ptymek/forma_wtryskowa_przts_WIP/DOC/WYPRASKA_NIEPRZEZROCZYSTA.BMP

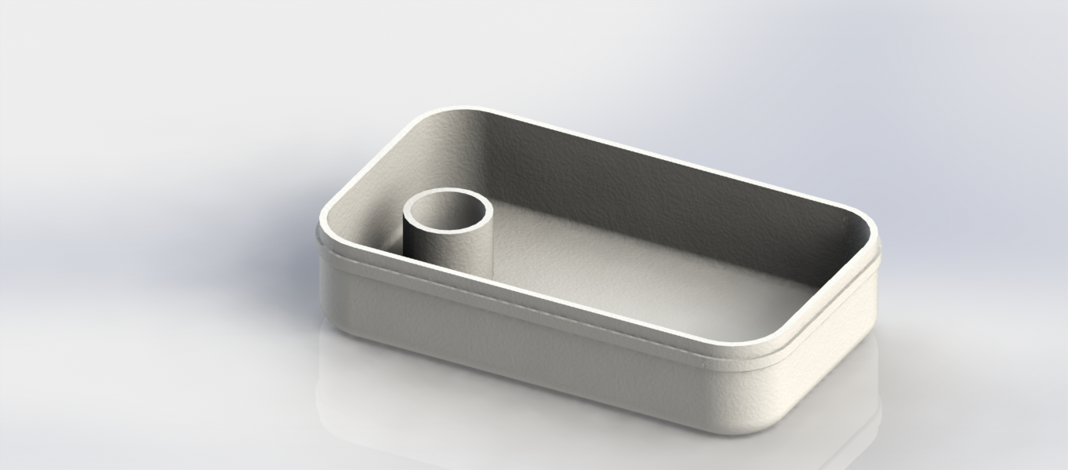
DOC/WYPRASKA_NIEPRZEZROCZYSTA.BMP
