ptymek/forma_wtryskowa_przts_WIP/DOC/WTRYSK.BMP

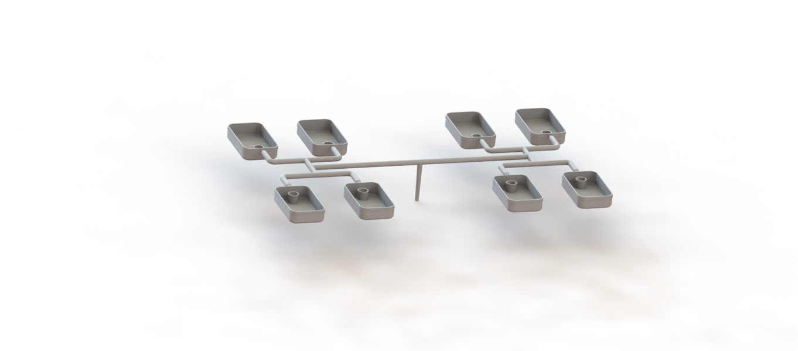
DOC/WTRYSK.BMP
