ptymek/forma_wtryskowa_przts_WIP/DOC/WYPRASKA_PRZEZROCZYSTA.BMP

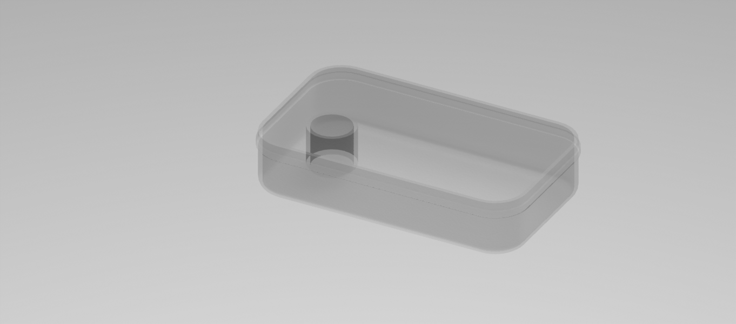
DOC/WYPRASKA_PRZEZROCZYSTA.BMP
