ptymek/forma_wtryskowa_przts_WIP/Przechwytywanie w trybie pełnoekranowym 2015-01-06 133430.bmp.jpg

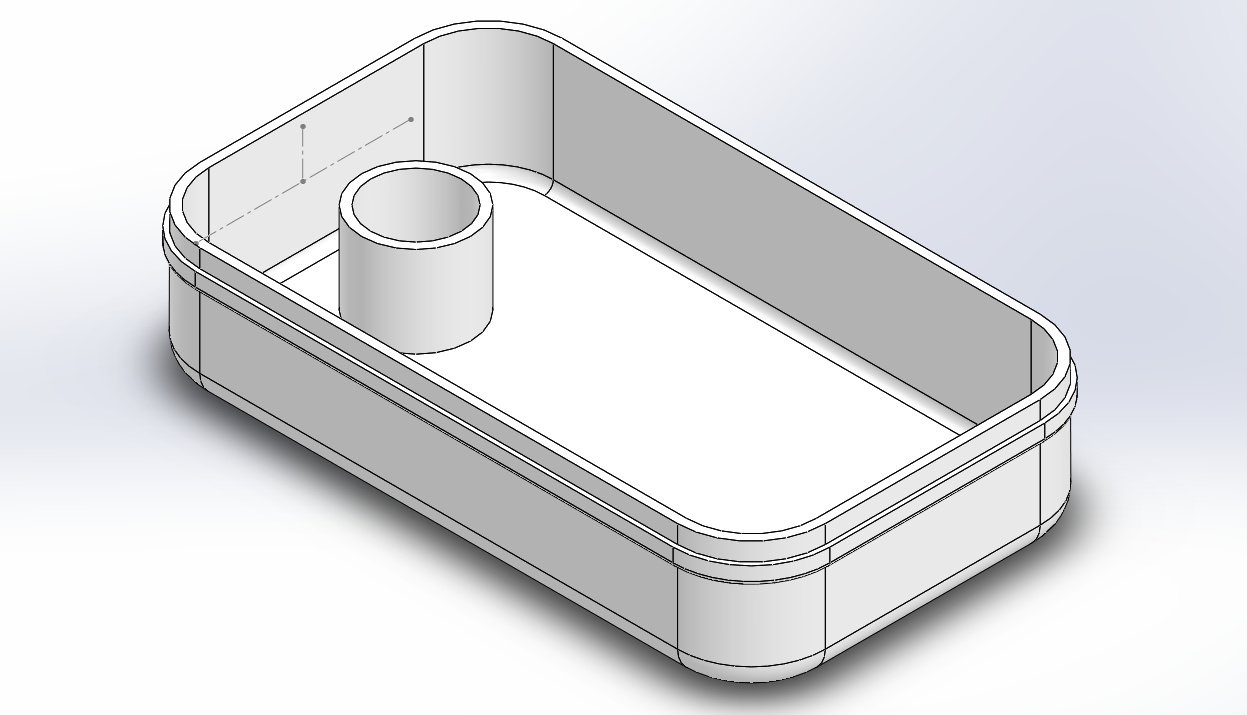
Przechwytywanie w trybie pełnoekranowym 2015-01-06 133430.bmp.jpg
