ptymek/forma_wtryskowa_przts_WIP/WYPRASKA/TYMIŃSKI_PRZTS_WTRYSK.SLDASM

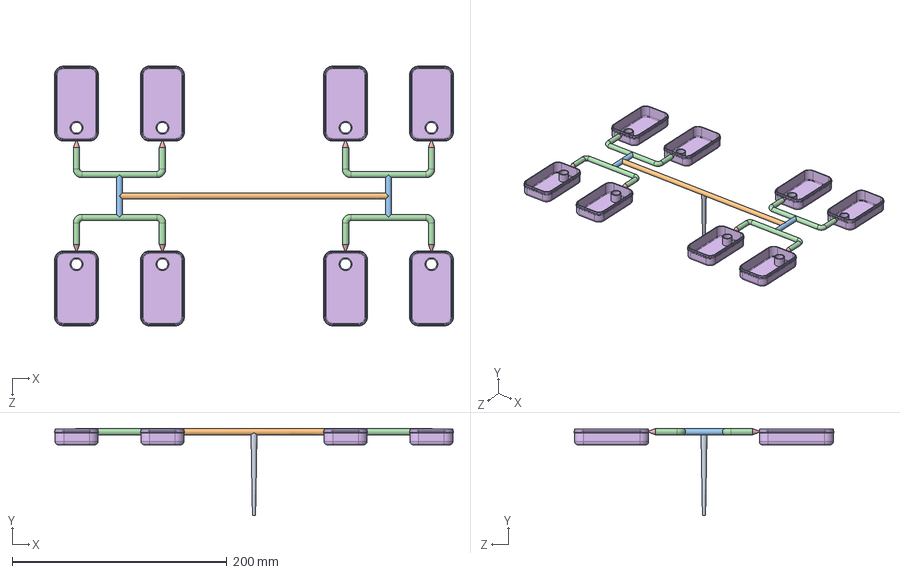
[picture p26: CAD file, 2019-07-03]
WYPRASKA/TYMIŃSKI_PRZTS_WTRYSK.SLDASM
371.5 x 81.0 x 242.0 mm
TYMIŃSKI_PRZTS_MODEL_KANAŁ_WTRYSKU
TYMIŃSKI_PRZTS_MODEL_KANAŁ_GŁOWNY
TYMIŃSKI_PRZTS_MODEL_KANAŁ_DOLOTOWY x 2
TYMIŃSKI_PRZTS_MODEL_ŁĄCZNIK x 4
TYMIŃSKI_PRZTS_MODEL_PRZEWĘŻKA x 8
TYMIŃSKI_PRZTS_WYPRASKA x 8
