ptymek/forma_wtryskowa_przts_WIP/ZŁOŻENIA/TYMIŃSKI_PRZTS_GÓRA.SLDASM

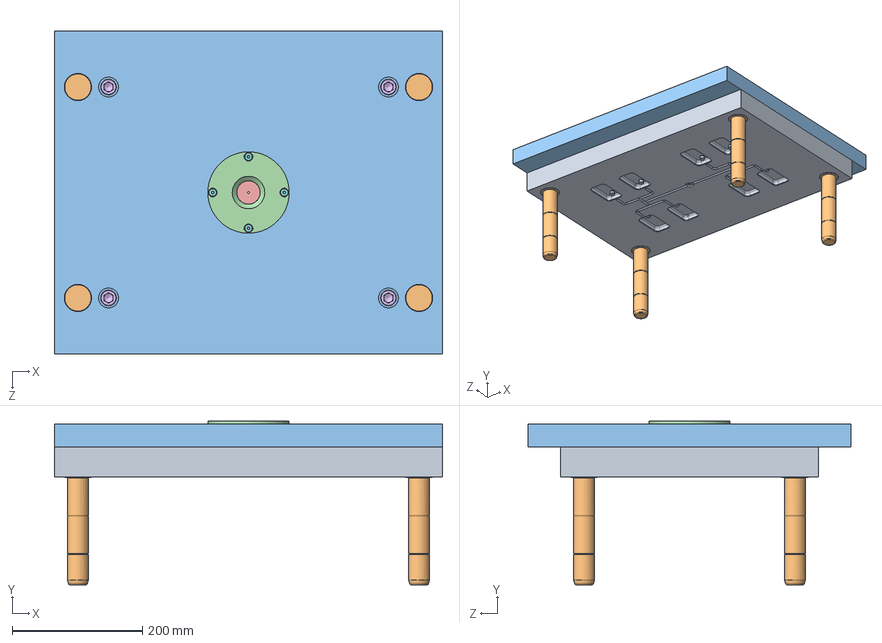
[picture p27: CAD file, 2019-07-03]
ZŁOŻENIA/TYMIŃSKI_PRZTS_GÓRA.SLDASM
596.0 x 251.3 x 496.0 mm
PK31_FORMA
SLE_32046165_1_7131 x 4
PK11_GÓRNA
PCA_125080_wg_FCPK
TWC_183056_1_8159
socket head cap screw_iso x 4
parallel pin hardened_iso
socket countersunk head screw_iso x 4
