ptymek/forma_wtryskowa_przts_WIP/ZŁOŻENIA/TYMIŃSKI_PRZTS_SPRĘŻYNA_WYPYCHACZY.SLDASM

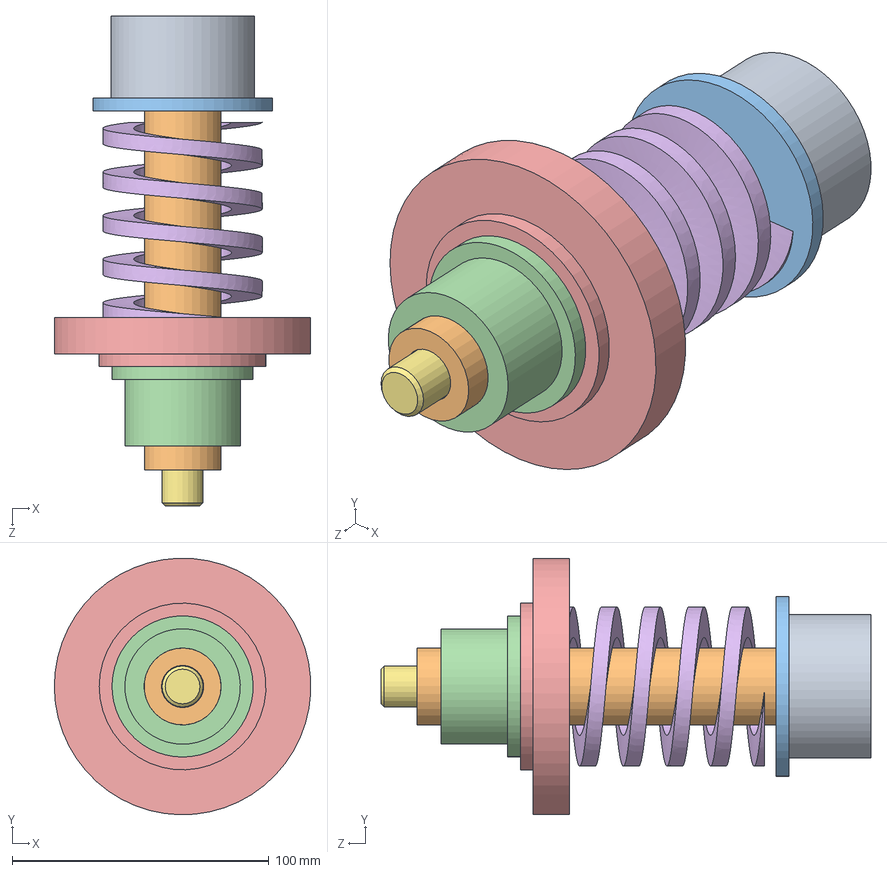
[picture p28: CAD file, 2019-07-03]
ZŁOŻENIA/TYMIŃSKI_PRZTS_SPRĘŻYNA_WYPYCHACZY.SLDASM
99.9 x 100.0 x 191.0 mm
POA_5632_wg_FCPK
TPZ_30140_wg_FCPK
WYPYCHACZ_PODKŁADKA
WYPYCHACZ_TULEJA_1
WYPYCHACZ_TULEJA_2
SPRĘŻYNA
SM_16170_wg_FCPK
