ptymek/forma_wtryskowa_przts_WIP/ZŁOŻENIA/TYMIŃSKI_PRZTS_PŁYTA_WYPYCHACZY.SLDASM

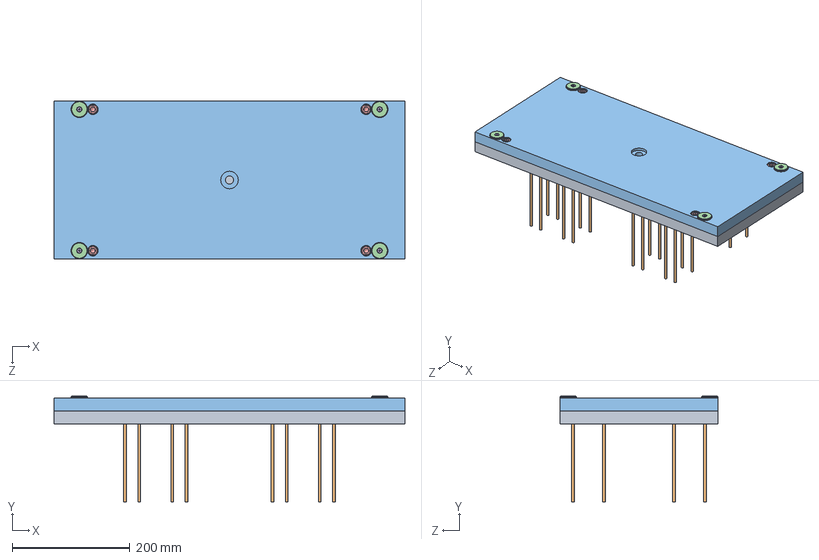
[picture p29: CAD file, 2019-07-03]
ZŁOŻENIA/TYMIŃSKI_PRZTS_PŁYTA_WYPYCHACZY.SLDASM
596.0 x 179.2 x 268.0 mm
PK06
EM_050160_1_2344 x 32
PK07
PO_2803_wg_FCPK x 4
socket head cap screw_iso x 4
socket countersunk head screw_iso x 4
