ptymek/forma_wtryskowa_przts_WIP/WYPRASKA/Złożenie2.SLDASM

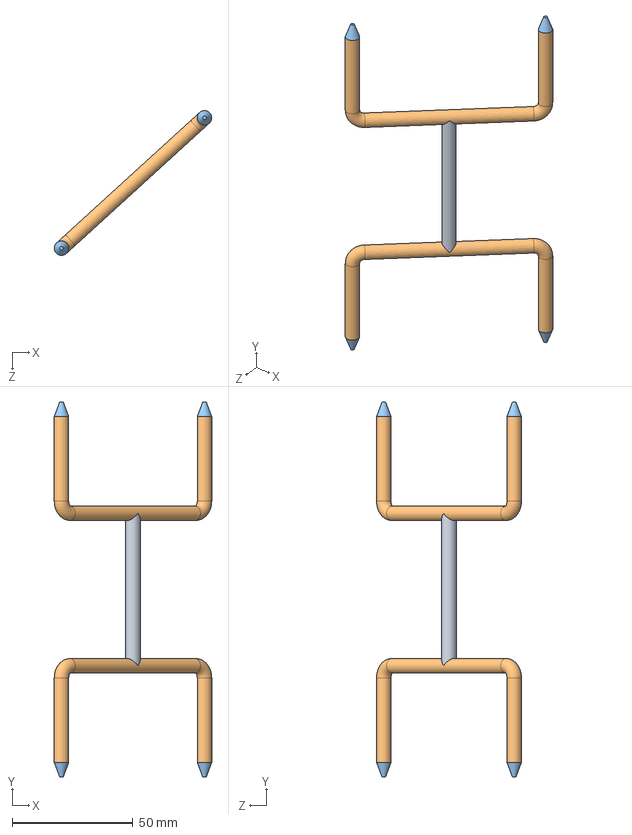
[picture p30: CAD file, 2019-07-03]
WYPRASKA/Złożenie2.SLDASM
65.1 x 155.0 x 59.9 mm
TYMIŃSKI_PRZTS_MODEL_KANAŁ_DOLOTOWY
TYMIŃSKI_PRZTS_MODEL_ŁĄCZNIK x 2
TYMIŃSKI_PRZTS_MODEL_PRZEWĘŻKA x 4
