ptymek/forma_wtryskowa_przts_WIP/ZŁOŻENIA/TYMIŃSKI_PRZTS_DÓŁ.SLDASM

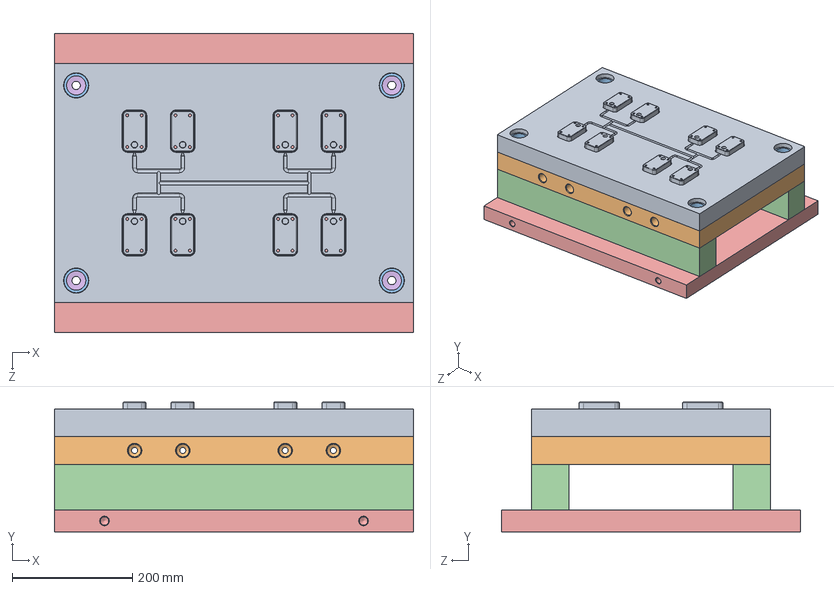
[picture p31: CAD file, 2019-07-03]
ZŁOŻENIA/TYMIŃSKI_PRZTS_DÓŁ.SLDASM
596.0 x 215.2 x 496.0 mm
PK31_MATRYCA
PK04
TPE_32036_1_7131 x 4
PK05
PK11_DOLNA
TUE_42140_1_7131 x 4
socket head cap screw_iso x 4
