ptymek/forma_wtryskowa_przts_WIP/FORMA_WTRYSKOWA/TYMIŃSKI_FORMA_WTRYSKOWA.SLDASM

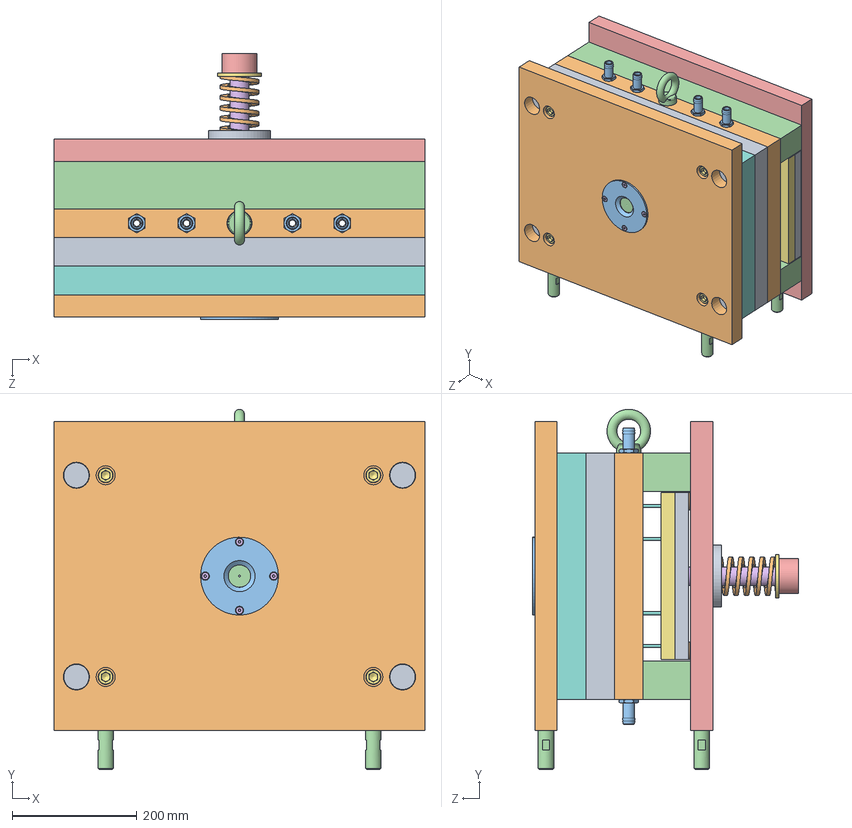
[picture p32: CAD file, 2019-07-03]
FORMA_WTRYSKOWA/TYMIŃSKI_FORMA_WTRYSKOWA.SLDASM
596.0 x 579.0 x 428.0 mm
PK31_MATRYCA
PK04
TPE_32036_1_7131 x 4
PK05
PK11_DOLNA
TUE_42140_1_7131 x 4
socket head cap screw_iso x 16
PK31_FORMA
SLE_32046165_1_7131 x 4
PK11_GÓRNA
PCA_125080_wg_FCPK
TWC_183056_1_8159
parallel pin hardened_iso
socket countersunk head screw_iso x 8
PK06
EM_050160_1_2344 x 32
PK07
PO_2803_wg_FCPK x 4
UHE_M24_MS58_Brass_ x 8
SUM_20_wg_FCPK
POA_5632_wg_FCPK
TPZ_30140_wg_FCPK
WYPYCHACZ_PODKŁADKA
WYPYCHACZ_TULEJA_1
WYPYCHACZ_TULEJA_2
SPRĘŻYNA
SM_16170_wg_FCPK
NF_16088_wg_FCPK x 4
