ptymek/forma_wtryskowa_przts_WIP/WYPRASKA/Złożenie2^TYMIŃSKI_PRZTS_WTRYSK.sldasm

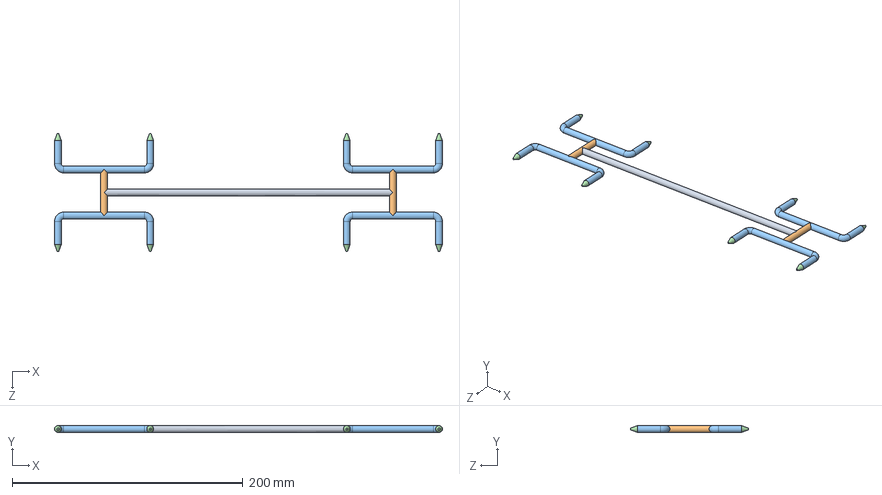
[picture p33: CAD file, 2019-07-03]
WYPRASKA/Złożenie2^TYMIŃSKI_PRZTS_WTRYSK.sldasm
336.5 x 6.00 x 102.0 mm
TYMIŃSKI_PRZTS_MODEL_KANAŁ_GŁOWNY
TYMIŃSKI_PRZTS_MODEL_KANAŁ_DOLOTOWY x 2
TYMIŃSKI_PRZTS_MODEL_ŁĄCZNIK x 4
TYMIŃSKI_PRZTS_MODEL_PRZEWĘŻKA x 8
