ptymek/forma_wtryskowa_przts_WIP/FORMA_WTRYSKOWA/ZESPÓŁ_WYPYCHACZY.SLDASM

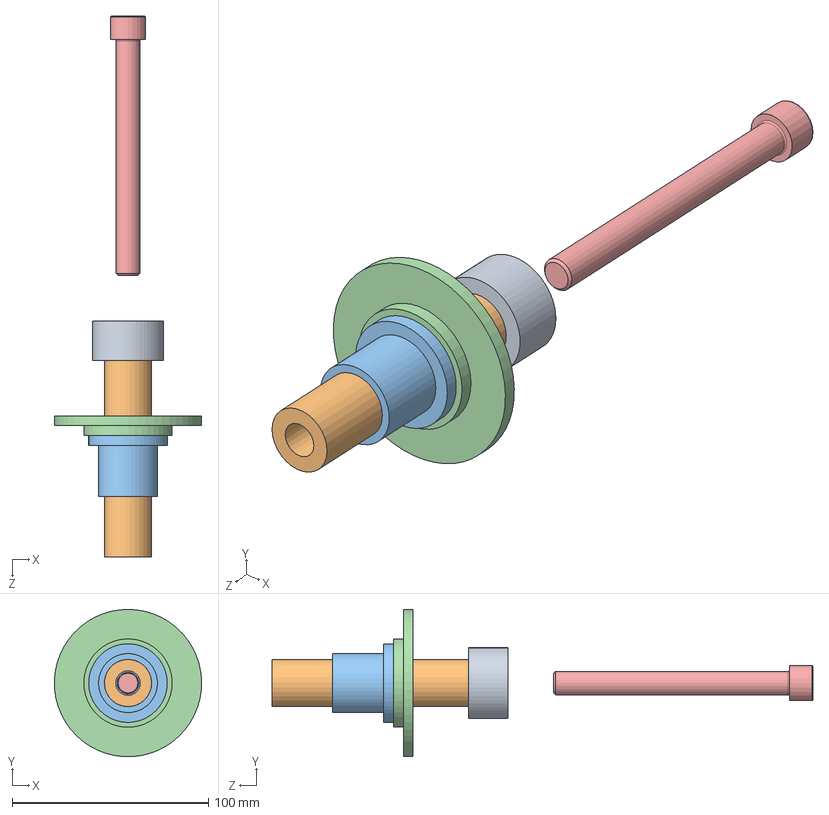
[picture p34: CAD file, 2019-07-03]
FORMA_WTRYSKOWA/ZESPÓŁ_WYPYCHACZY.SLDASM
75.0 x 74.9 x 275.4 mm
POA_3620_wg_FCPK
TPZ_24100_wg_FCPK
WYPYCHACZ_TULEJA_1
WYPYCHACZ_TULEJA_2
socket head cap screw_iso
