ptymek/forma_wtryskowa_przts_WIP/FORMA_WTRYSKOWA/CZĘŚĆI_ZNORMALIZOWANE/EM_050125_1_2344.sldprt

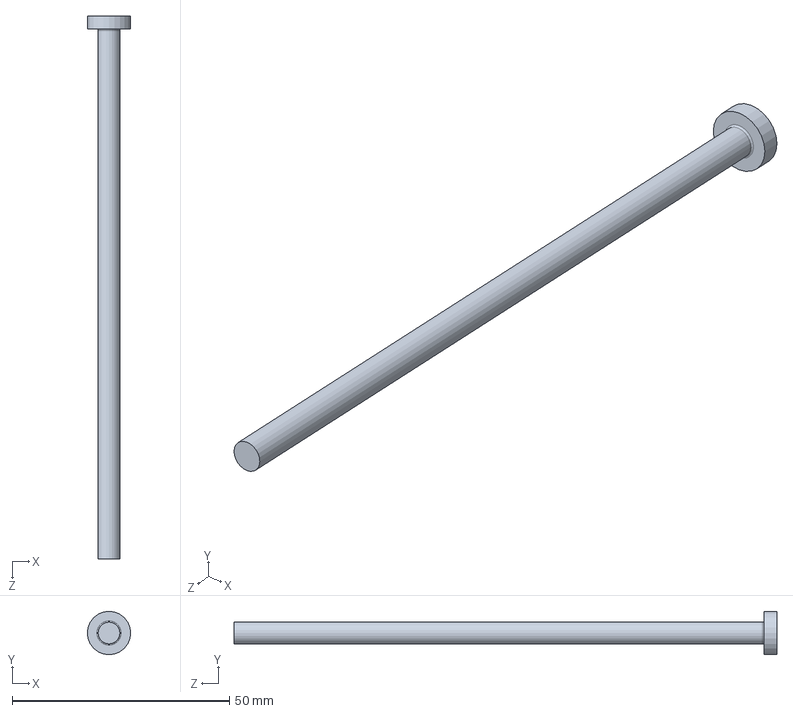
[picture p35: CAD file, 2019-07-03]
FORMA_WTRYSKOWA/CZĘŚĆI_ZNORMALIZOWANE/EM_050125_1_2344.sldprt
10.0 x 10.0 x 125.0 mm
