ptymek/forma_wtryskowa_przts_WIP/FORMA_WTRYSKOWA/CZĘŚĆI_ZNORMALIZOWANE/FCPKBYTOW/SM_16150_wg_FCPK.sldprt

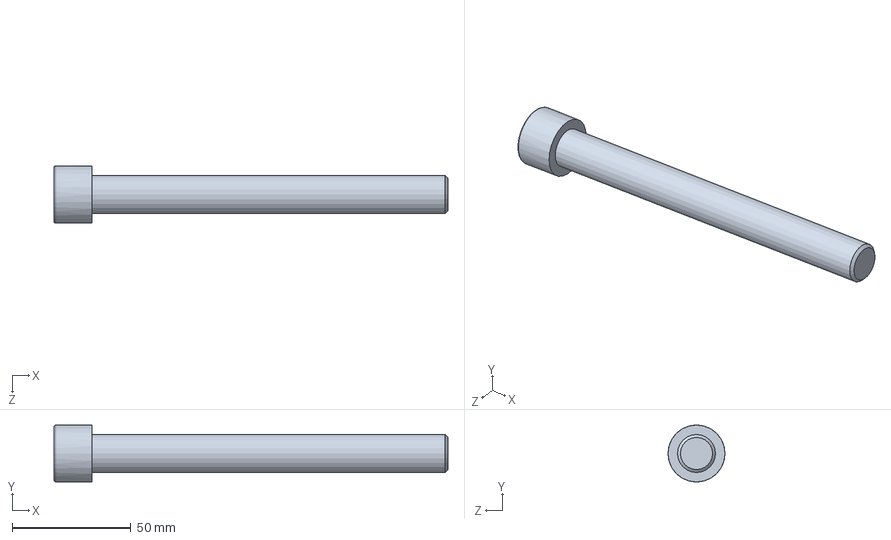
[picture p36: CAD file, 2019-07-03]
FORMA_WTRYSKOWA/CZĘŚĆI_ZNORMALIZOWANE/FCPKBYTOW/SM_16150_wg_FCPK.sldprt
166.0 x 24.0 x 24.0 mm
