ptymek/forma_wtryskowa_przts_WIP/FORMA_WTRYSKOWA/PODKŁADKA_OPOROWA.SLDPRT

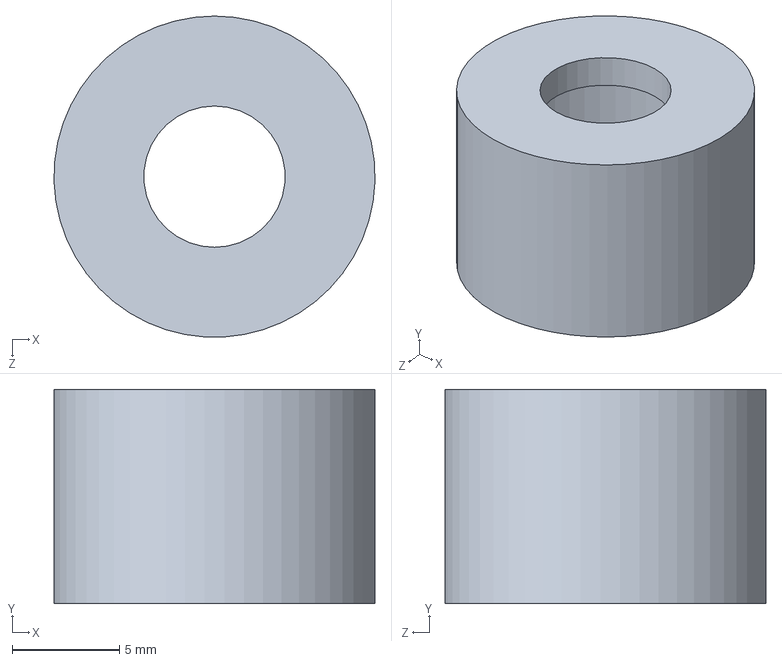
[picture p37: CAD file, 2019-07-03]
FORMA_WTRYSKOWA/PODKŁADKA_OPOROWA.SLDPRT
15.0 x 10.0 x 15.0 mm
