ptymek/forma_wtryskowa_przts_WIP/FORMA_WTRYSKOWA/CZĘŚĆI_ZNORMALIZOWANE/FCPKBYTOW/WK_0408_wg_DIN.sldprt

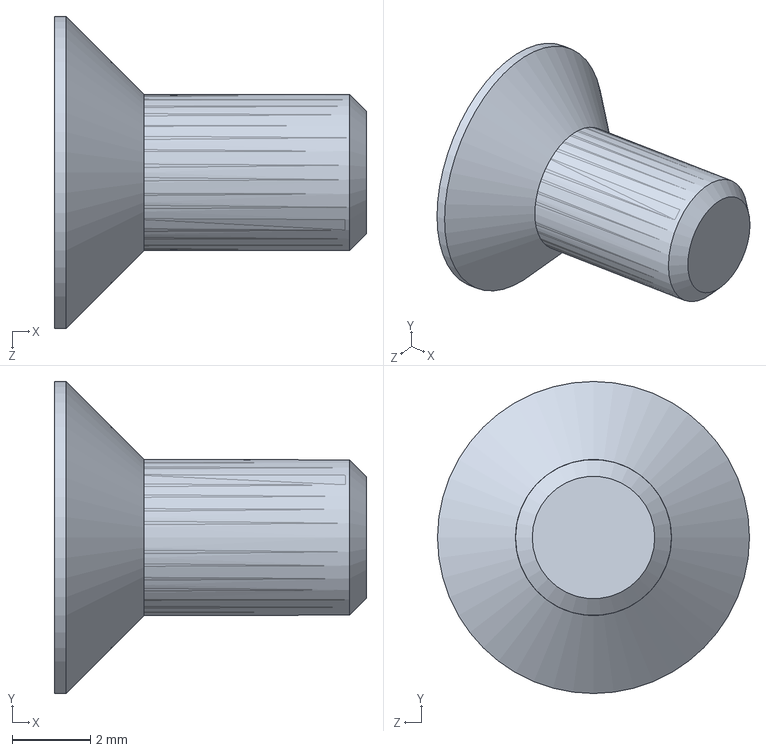
[picture p38: CAD file, 2019-07-03]
FORMA_WTRYSKOWA/CZĘŚĆI_ZNORMALIZOWANE/FCPKBYTOW/WK_0408_wg_DIN.sldprt
8.00 x 8.00 x 8.00 mm
