ptymek/forma_wtryskowa_przts_WIP/FORMA_WTRYSKOWA/CZĘŚĆI_ZNORMALIZOWANE/parallel pin hardened_iso.sldprt

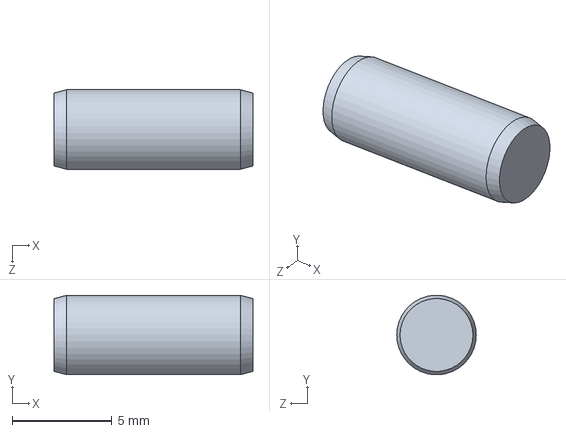
[picture p39: CAD file, 2019-07-03]
FORMA_WTRYSKOWA/CZĘŚĆI_ZNORMALIZOWANE/parallel pin hardened_iso.sldprt
10.0 x 3.99 x 4.00 mm
