ptymek/forma_wtryskowa_przts_WIP/FORMA_WTRYSKOWA/WYPYCHACZ_TULEJA_1.SLDPRT

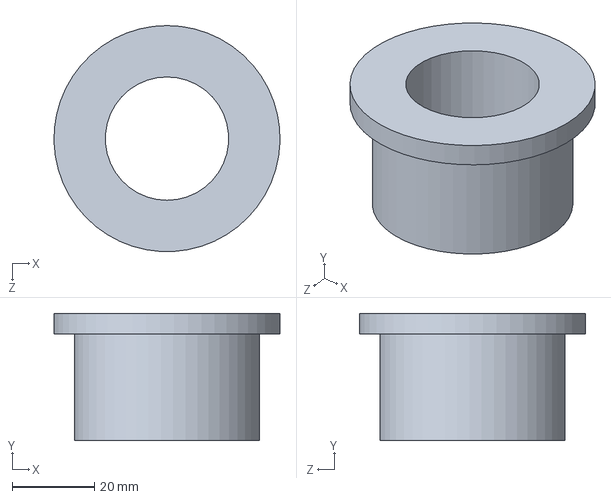
[picture p40: CAD file, 2019-07-03]
FORMA_WTRYSKOWA/WYPYCHACZ_TULEJA_1.SLDPRT
55.0 x 31.0 x 54.9 mm
