ptymek/forma_wtryskowa_przts_WIP/WYPRASKA/TYMIŃSKI_PRZTS_MODEL.SLDPRT

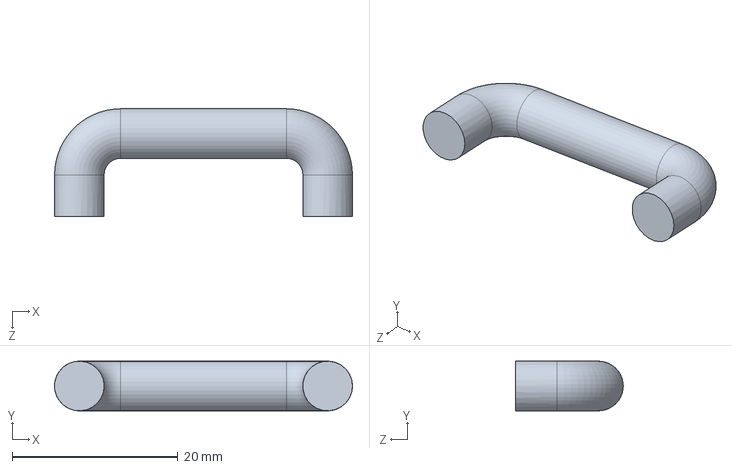
[picture p41: CAD file, 2019-07-03]
WYPRASKA/TYMIŃSKI_PRZTS_MODEL.SLDPRT
36.0 x 5.99 x 13.0 mm
