ptymek/forma_wtryskowa_przts_WIP/FORMA_WTRYSKOWA/CZĘŚĆI_ZNORMALIZOWANE/FCPKBYTOW/PK_11_496x596x36_35_1730_1_1730.sldprt

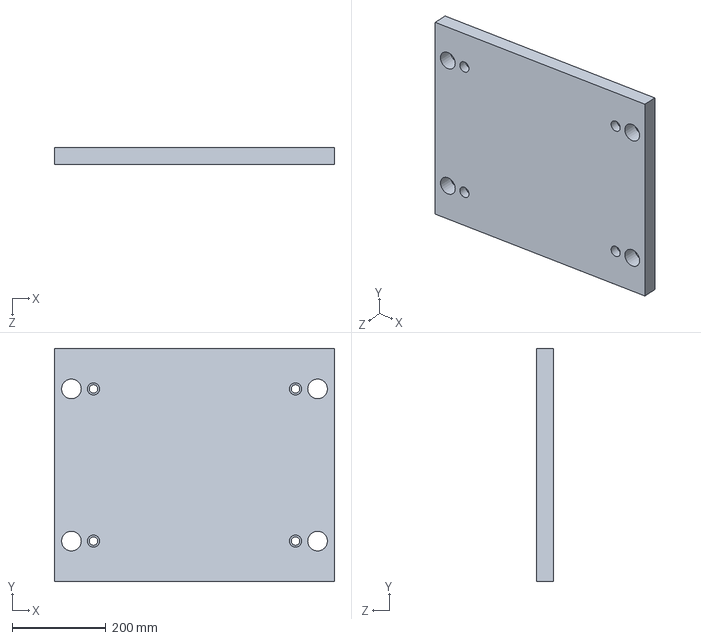
[picture p42: CAD file, 2019-07-03]
FORMA_WTRYSKOWA/CZĘŚĆI_ZNORMALIZOWANE/FCPKBYTOW/PK_11_496x596x36_35_1730_1_1730.sldprt
596.0 x 496.0 x 36.0 mm
