ptymek/forma_wtryskowa_przts_WIP/FORMA_WTRYSKOWA/CZĘŚĆI_ZNORMALIZOWANE/NF_16088_wg_FCPK.sldprt

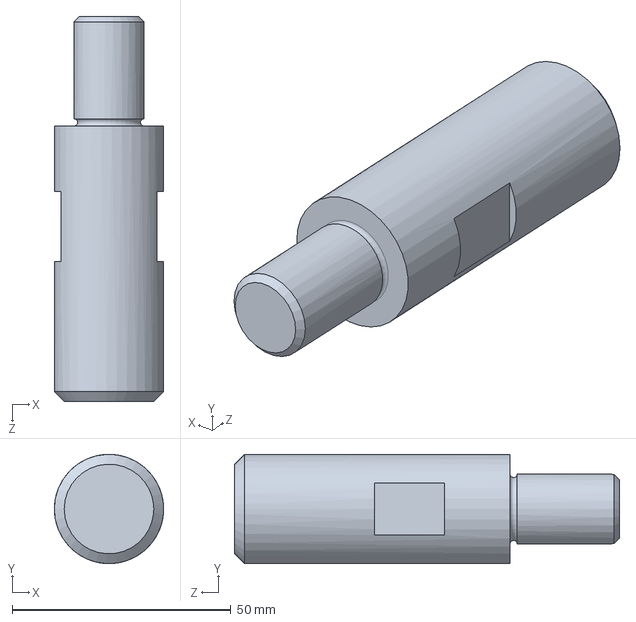
[picture p43: CAD file, 2019-07-03]
FORMA_WTRYSKOWA/CZĘŚĆI_ZNORMALIZOWANE/NF_16088_wg_FCPK.sldprt
25.0 x 25.0 x 88.0 mm
