ptymek/forma_wtryskowa_przts_WIP/FORMA_WTRYSKOWA/PK05.SLDPRT

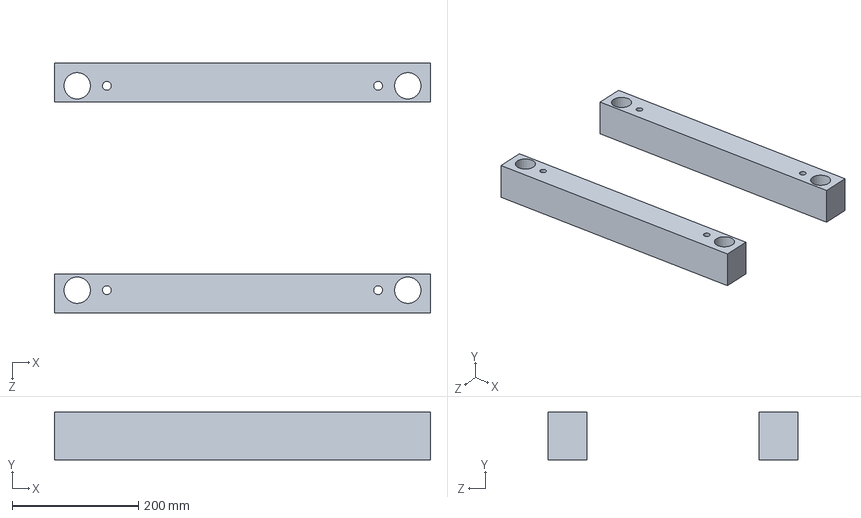
[picture p44: CAD file, 2019-07-03]
FORMA_WTRYSKOWA/PK05.SLDPRT
596.0 x 76.0 x 396.0 mm
