ptymek/forma_wtryskowa_przts_WIP/WYPRASKA/TYMIŃSKI_PRZTS_MODEL_PRZEWĘŻKA.SLDPRT

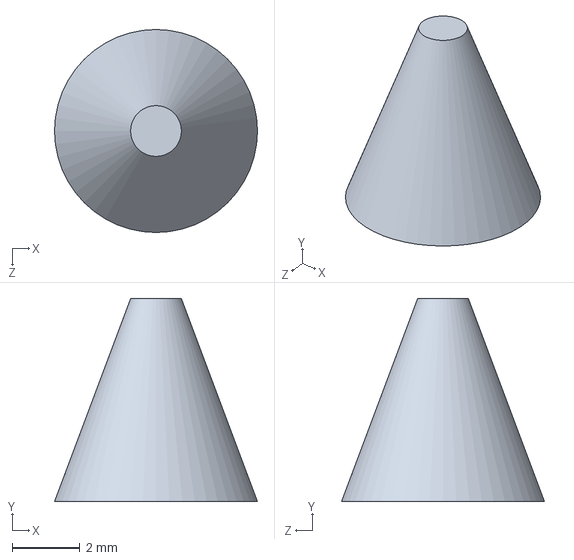
[picture p45: CAD file, 2019-07-03]
WYPRASKA/TYMIŃSKI_PRZTS_MODEL_PRZEWĘŻKA.SLDPRT
6.00 x 6.00 x 6.00 mm
