ptymek/forma_wtryskowa_przts_WIP/FORMA_WTRYSKOWA/CZĘŚĆI_ZNORMALIZOWANE/FCPKBYTOW/PK07_268x596x27_35_1730_1_1730.sldprt

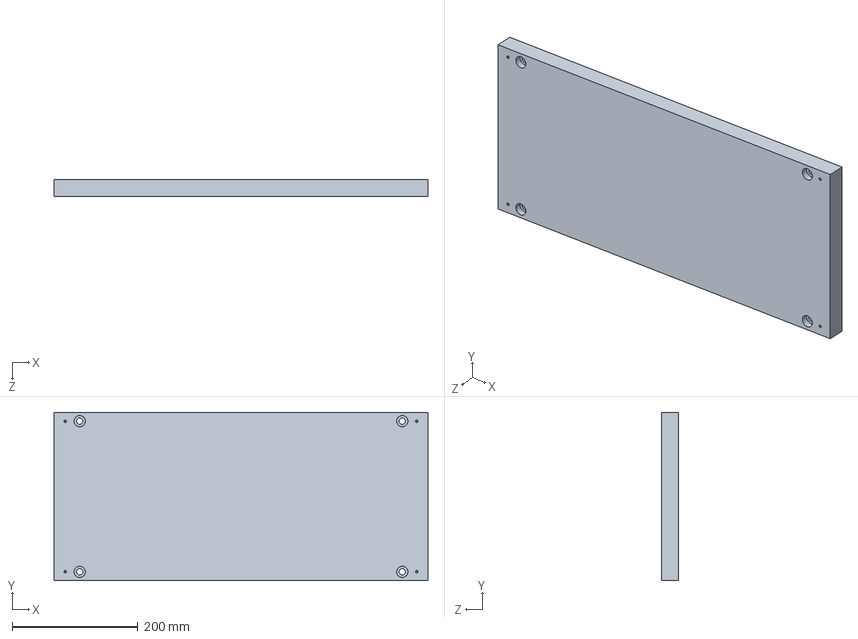
[picture p46: CAD file, 2019-07-03]
FORMA_WTRYSKOWA/CZĘŚĆI_ZNORMALIZOWANE/FCPKBYTOW/PK07_268x596x27_35_1730_1_1730.sldprt
596.0 x 268.0 x 27.0 mm
