ptymek/forma_wtryskowa_przts_WIP/FORMA_WTRYSKOWA/WYPYCHACZ_TULEJA_2.SLDPRT

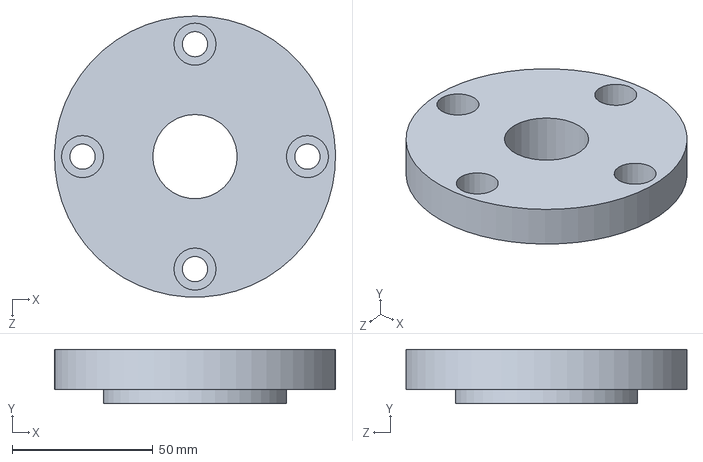
[picture p47: CAD file, 2019-07-03]
FORMA_WTRYSKOWA/WYPYCHACZ_TULEJA_2.SLDPRT
100.0 x 19.2 x 99.9 mm
