ptymek/forma_wtryskowa_przts_WIP/FORMA_WTRYSKOWA/CZĘŚĆI_ZNORMALIZOWANE/FCPKBYTOW/PK_05_62x596x76_35_1730_1_1730.sldprt

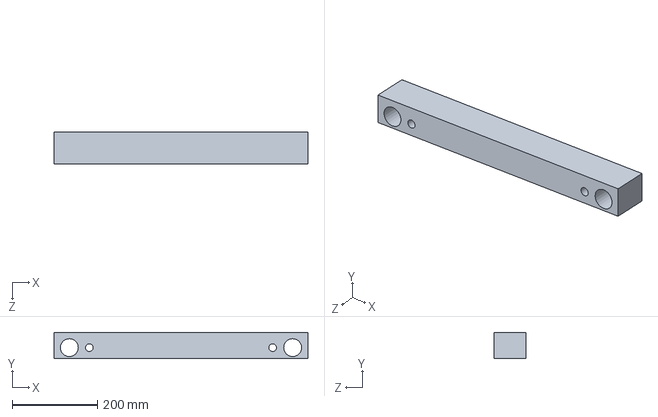
[picture p48: CAD file, 2019-07-03]
FORMA_WTRYSKOWA/CZĘŚĆI_ZNORMALIZOWANE/FCPKBYTOW/PK_05_62x596x76_35_1730_1_1730.sldprt
596.0 x 62.0 x 76.0 mm
