ptymek/forma_wtryskowa_przts_WIP/FORMA_WTRYSKOWA/CZĘŚĆI_ZNORMALIZOWANE/TPE_32036_1_7131.sldprt

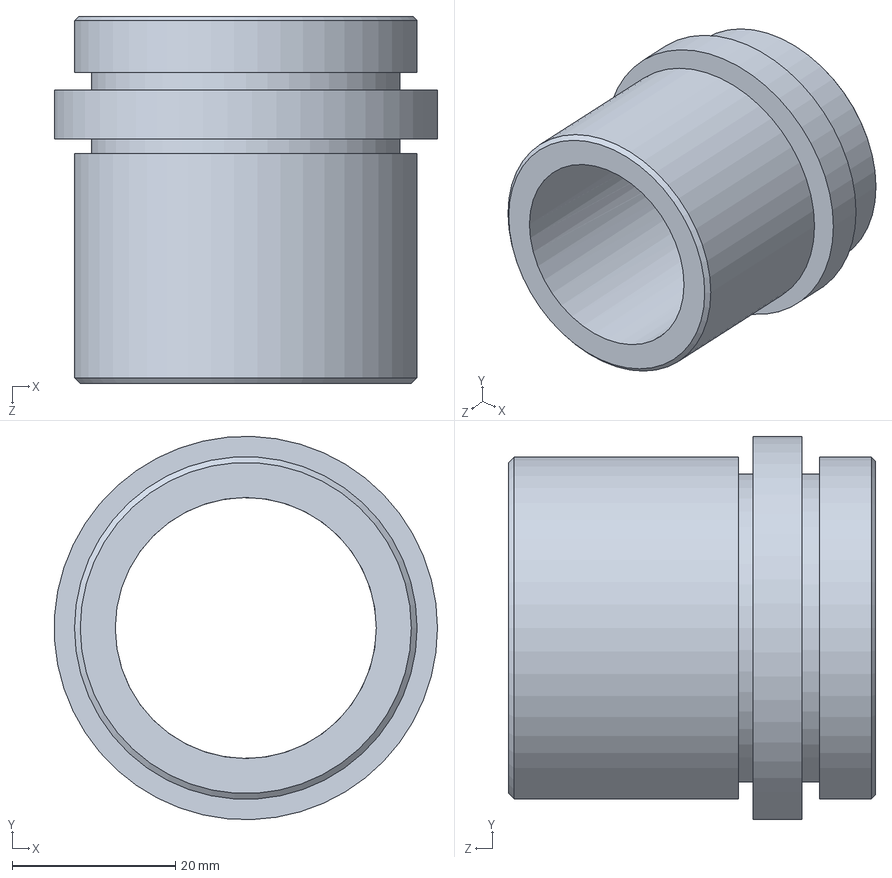
[picture p49: CAD file, 2019-07-03]
FORMA_WTRYSKOWA/CZĘŚĆI_ZNORMALIZOWANE/TPE_32036_1_7131.sldprt
47.0 x 47.0 x 45.0 mm
