ptymek/forma_wtryskowa_przts_WIP/FORMA_WTRYSKOWA/TULEJA_PROWADZĄCA.SLDPRT

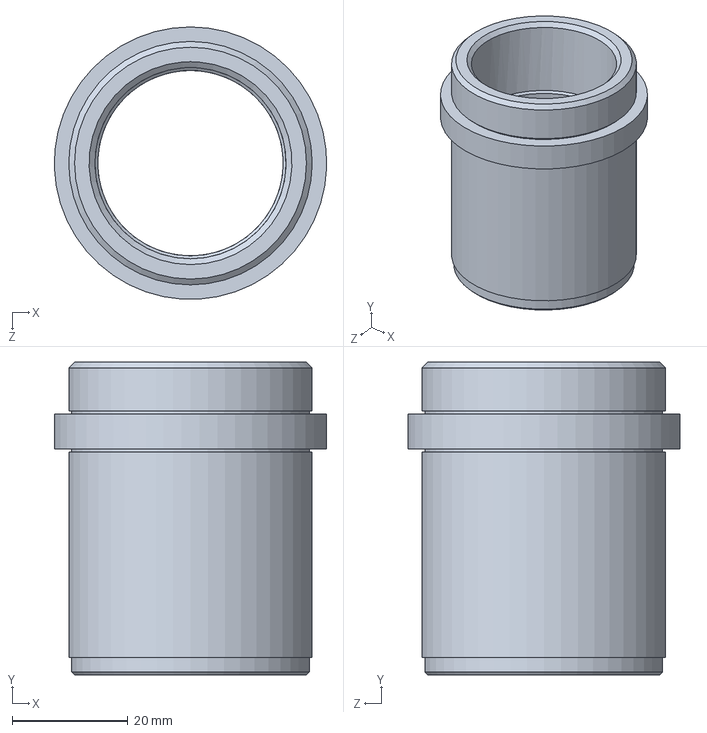
[picture p50: CAD file, 2019-07-03]
FORMA_WTRYSKOWA/TULEJA_PROWADZĄCA.SLDPRT
47.0 x 54.0 x 46.9 mm
