ptymek/forma_wtryskowa_przts_WIP/WYPRASKA/TYMIŃSKI_PRZTS_MODEL_ŁĄCZNIK.SLDPRT

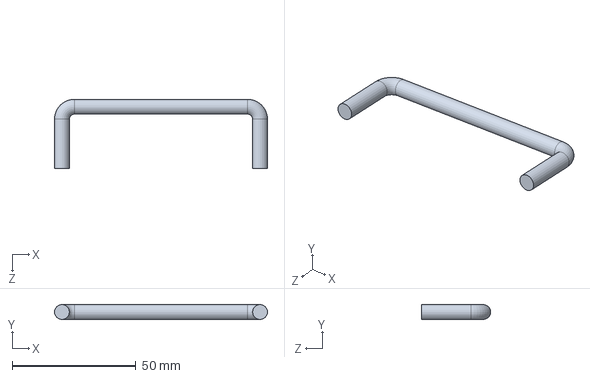
[picture p51: CAD file, 2019-07-03]
WYPRASKA/TYMIŃSKI_PRZTS_MODEL_ŁĄCZNIK.SLDPRT
86.0 x 6.00 x 28.0 mm
