ptymek/forma_wtryskowa_przts_WIP/FORMA_WTRYSKOWA/CZĘŚĆI_ZNORMALIZOWANE/FCPKBYTOW/PO_1803_wg_FCPK.sldprt

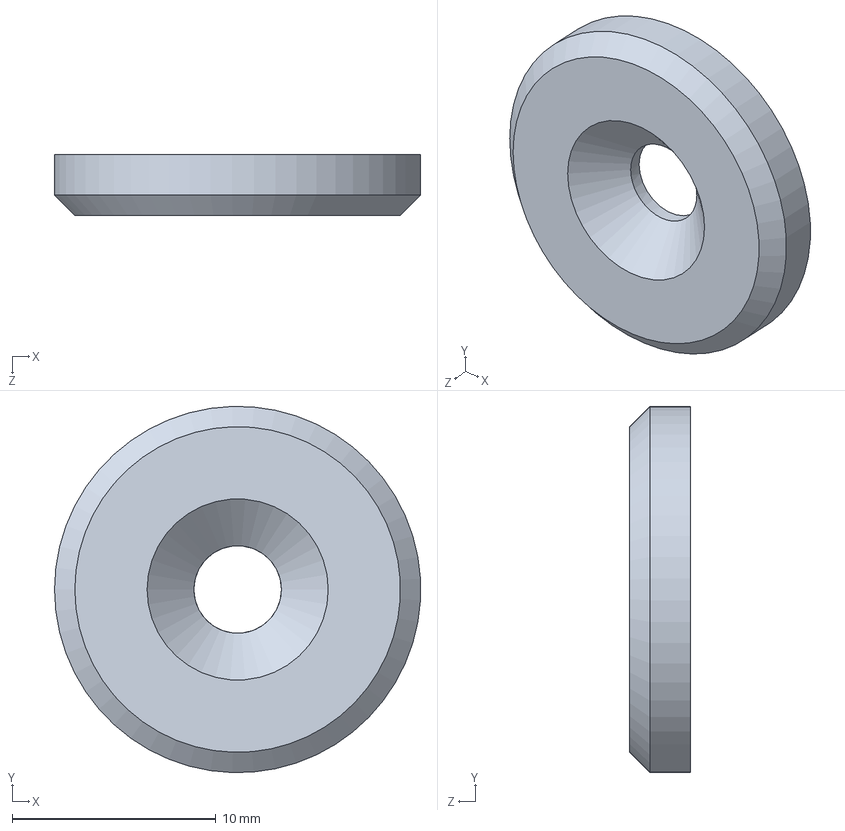
[picture p52: CAD file, 2019-07-03]
FORMA_WTRYSKOWA/CZĘŚĆI_ZNORMALIZOWANE/FCPKBYTOW/PO_1803_wg_FCPK.sldprt
18.0 x 18.0 x 3.00 mm
