ptymek/forma_wtryskowa_przts_WIP/FORMA_WTRYSKOWA/CZĘŚĆI_ZNORMALIZOWANE/SUM_20_wg_FCPK.sldprt

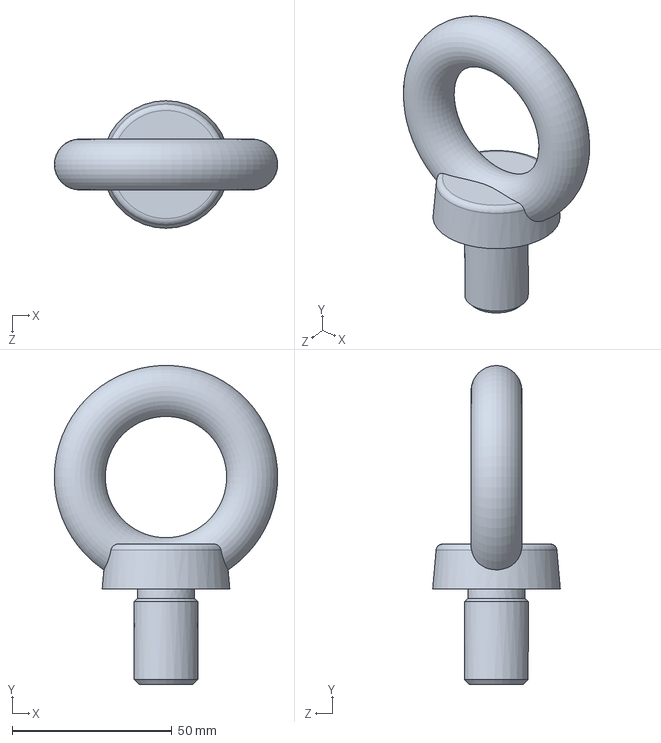
[picture p53: CAD file, 2019-07-03]
FORMA_WTRYSKOWA/CZĘŚĆI_ZNORMALIZOWANE/SUM_20_wg_FCPK.sldprt
70.0 x 100.0 x 40.0 mm
