ptymek/forma_wtryskowa_przts_WIP/WYPRASKA/TYMIŃSKI_PRZTS_WYPRASKA.SLDPRT

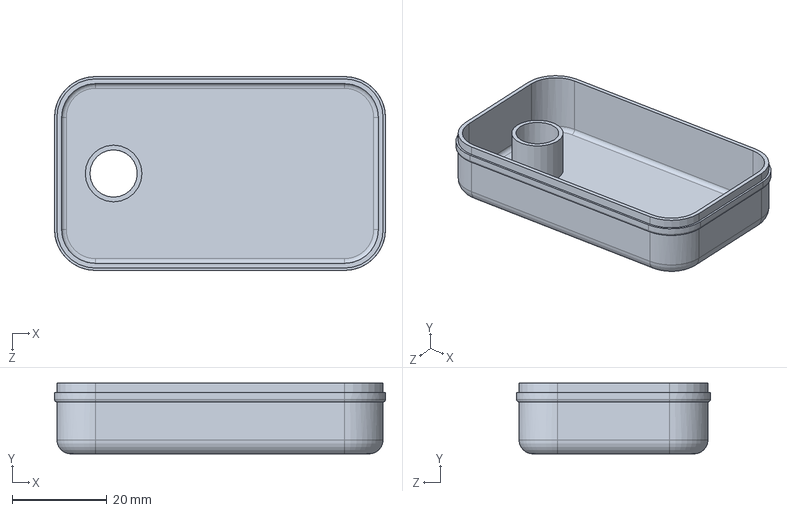
[picture p55: CAD file, 2019-07-03]
WYPRASKA/TYMIŃSKI_PRZTS_WYPRASKA.SLDPRT
70.0 x 15.0 x 41.0 mm
