ptymek/forma_wtryskowa_przts_WIP/FORMA_WTRYSKOWA/CZĘŚĆI_ZNORMALIZOWANE/FCPKBYTOW/PK03_396x596x46_35_1730_1_1730.sldprt

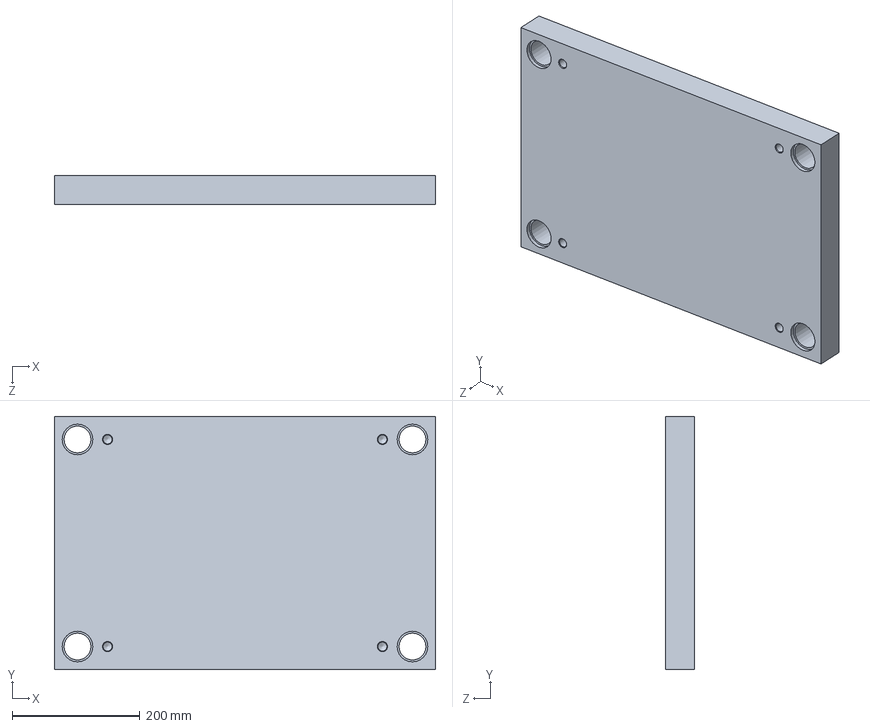
[picture p56: CAD file, 2019-07-03]
FORMA_WTRYSKOWA/CZĘŚĆI_ZNORMALIZOWANE/FCPKBYTOW/PK03_396x596x46_35_1730_1_1730.sldprt
596.0 x 396.0 x 46.0 mm
