ptymek/forma_wtryskowa_przts_WIP/FORMA_WTRYSKOWA/CZĘŚĆI_ZNORMALIZOWANE/SUM_30_wg_FCPK.sldprt

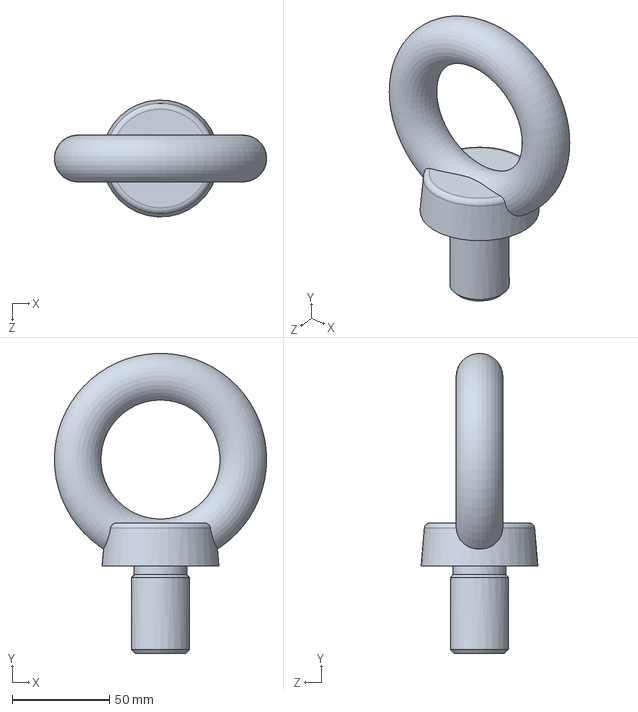
[picture p57: CAD file, 2019-07-03]
FORMA_WTRYSKOWA/CZĘŚĆI_ZNORMALIZOWANE/SUM_30_wg_FCPK.sldprt
108.9 x 153.9 x 59.9 mm
