ptymek/forma_wtryskowa_przts_WIP/WYPRASKA/TYMIŃSKI_PRZTS_MODEL_KANAŁ_WTRYSKU.SLDPRT

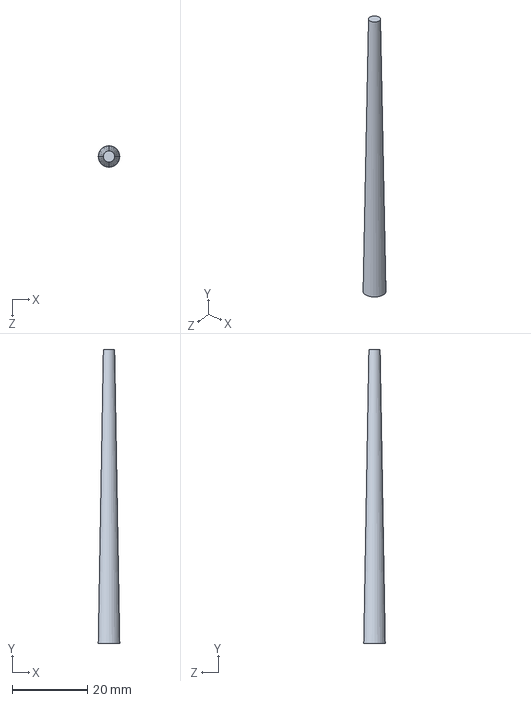
[picture p58: CAD file, 2019-07-03]
WYPRASKA/TYMIŃSKI_PRZTS_MODEL_KANAŁ_WTRYSKU.SLDPRT
5.72 x 78.0 x 5.72 mm
