ptymek/forma_wtryskowa_przts_WIP/FORMA_WTRYSKOWA/CZĘŚĆI_ZNORMALIZOWANE/UHE_M24_MS58_Brass_.sldprt

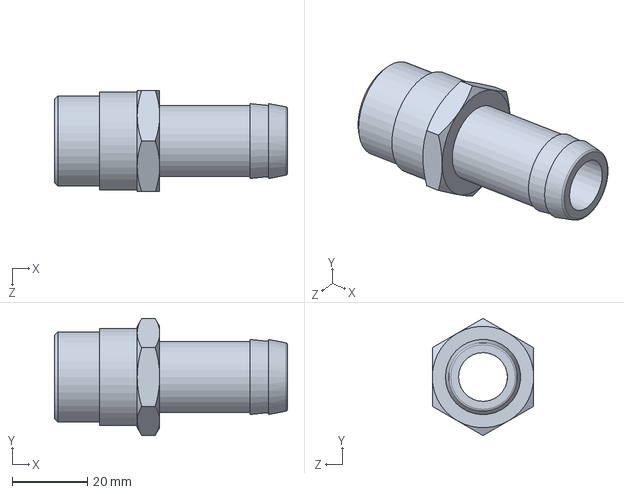
[picture p60: CAD file, 2019-07-03]
FORMA_WTRYSKOWA/CZĘŚĆI_ZNORMALIZOWANE/UHE_M24_MS58_Brass_.sldprt
62.0 x 31.2 x 27.0 mm
