ptymek/forma_wtryskowa_przts_WIP/FORMA_WTRYSKOWA/SPRĘŻYNA.SLDPRT

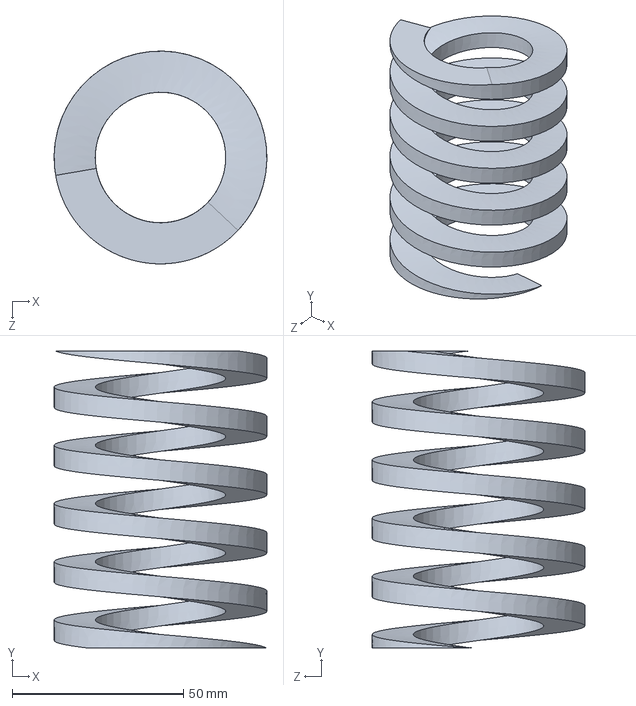
[picture p61: CAD file, 2019-07-03]
FORMA_WTRYSKOWA/SPRĘŻYNA.SLDPRT
62.2 x 86.8 x 62.2 mm
