ptymek/forma_wtryskowa_przts_WIP/WYPRASKA/TYMIŃSKI_PRZTS_MODEL_KANAŁ_DOLOTOWY.SLDPRT

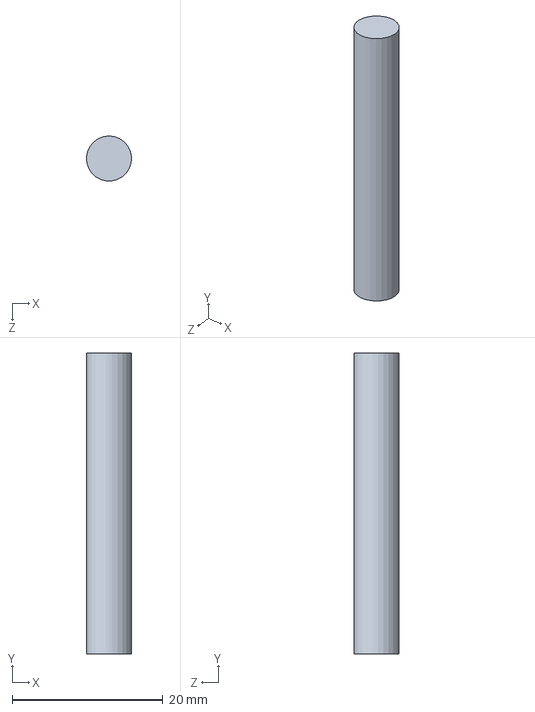
[picture p62: CAD file, 2019-07-03]
WYPRASKA/TYMIŃSKI_PRZTS_MODEL_KANAŁ_DOLOTOWY.SLDPRT
5.99 x 40.0 x 6.00 mm
