ptymek/forma_wtryskowa_przts_WIP/FORMA_WTRYSKOWA/CZĘŚĆI_ZNORMALIZOWANE/FCPKBYTOW/SM_16030_wg_FCPK.sldprt

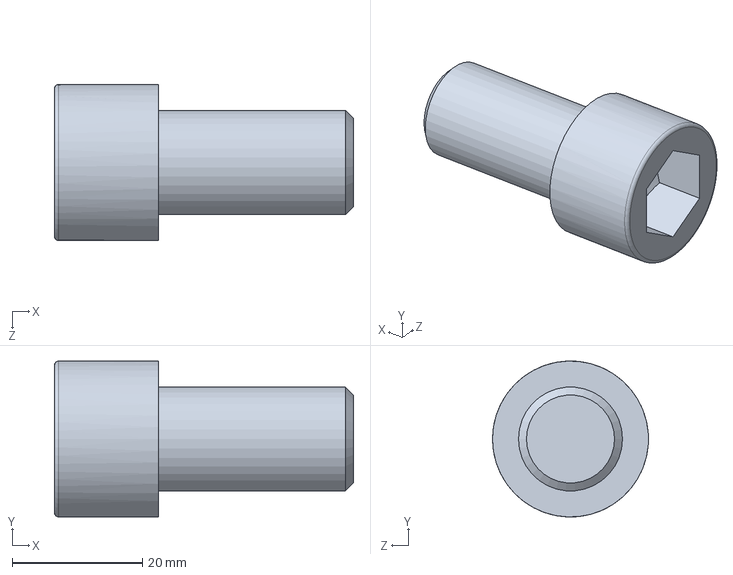
[picture p63: CAD file, 2019-07-03]
FORMA_WTRYSKOWA/CZĘŚĆI_ZNORMALIZOWANE/FCPKBYTOW/SM_16030_wg_FCPK.sldprt
46.0 x 24.0 x 24.0 mm
