ptymek/forma_wtryskowa_przts_WIP/FORMA_WTRYSKOWA/CZĘŚĆI_ZNORMALIZOWANE/SM_16170_wg_FCPK.sldprt

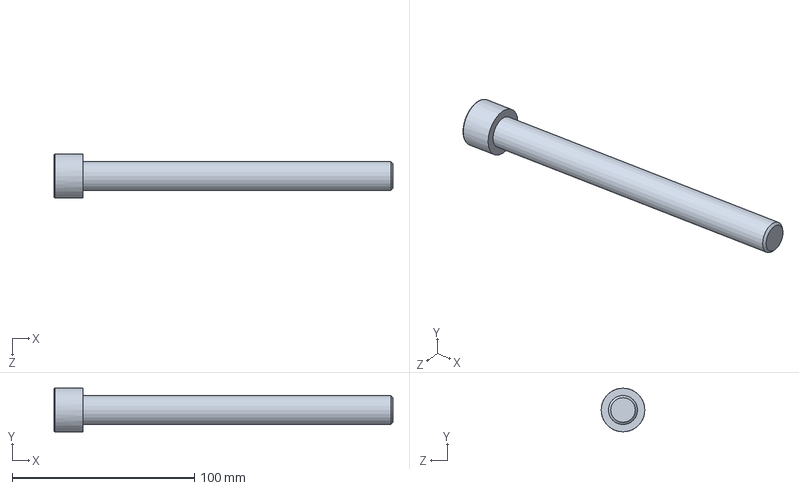
[picture p64: CAD file, 2019-07-03]
FORMA_WTRYSKOWA/CZĘŚĆI_ZNORMALIZOWANE/SM_16170_wg_FCPK.sldprt
186.0 x 24.0 x 24.0 mm
