ptymek/forma_wtryskowa_przts_WIP/FORMA_WTRYSKOWA/TULEJA_USTALAJĄCA.SLDPRT

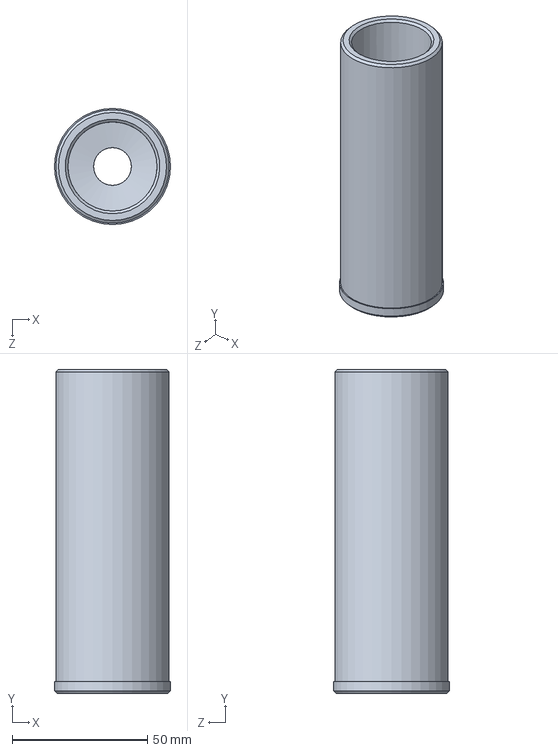
[picture p65: CAD file, 2019-07-03]
FORMA_WTRYSKOWA/TULEJA_USTALAJĄCA.SLDPRT
43.0 x 120.0 x 43.0 mm
