ptymek/forma_wtryskowa_przts_WIP/WYPRASKA/TYMIŃSKI_PRZTS_MODEL_KANAŁ_GŁOWNY.SLDPRT

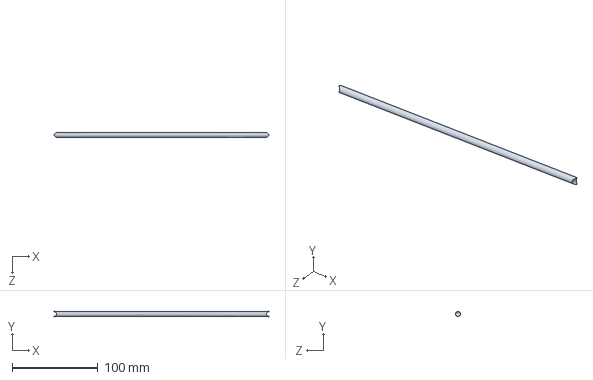
[picture p66: CAD file, 2019-07-03]
WYPRASKA/TYMIŃSKI_PRZTS_MODEL_KANAŁ_GŁOWNY.SLDPRT
250.0 x 6.00 x 6.00 mm
