ptymek/forma_wtryskowa_przts_WIP/FORMA_WTRYSKOWA/CZĘŚĆI_ZNORMALIZOWANE/FCPKBYTOW/PS_16_3x3_2_wg_PN.sldprt

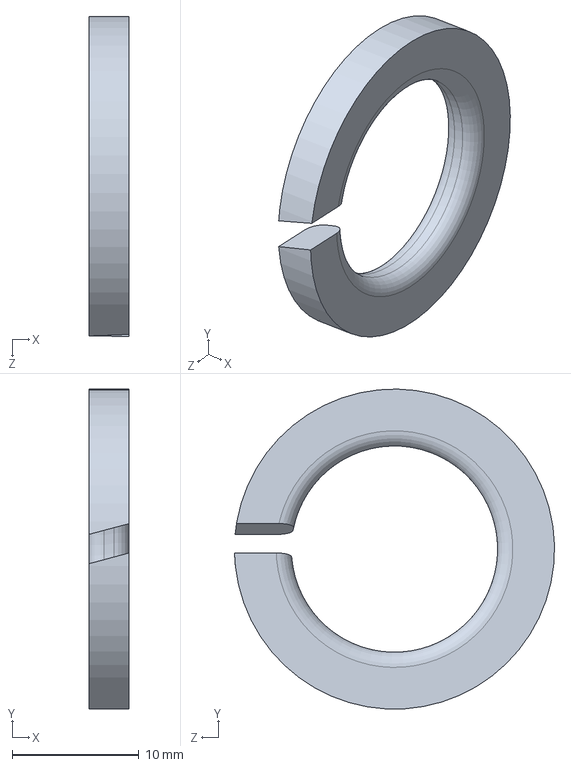
[picture p67: CAD file, 2019-07-03]
FORMA_WTRYSKOWA/CZĘŚĆI_ZNORMALIZOWANE/FCPKBYTOW/PS_16_3x3_2_wg_PN.sldprt
3.20 x 25.3 x 25.3 mm
