ptymek/forma_wtryskowa_przts_WIP/FORMA_WTRYSKOWA/CZĘŚĆI_ZNORMALIZOWANE/TPZ_30120_wg_FCPK.sldprt

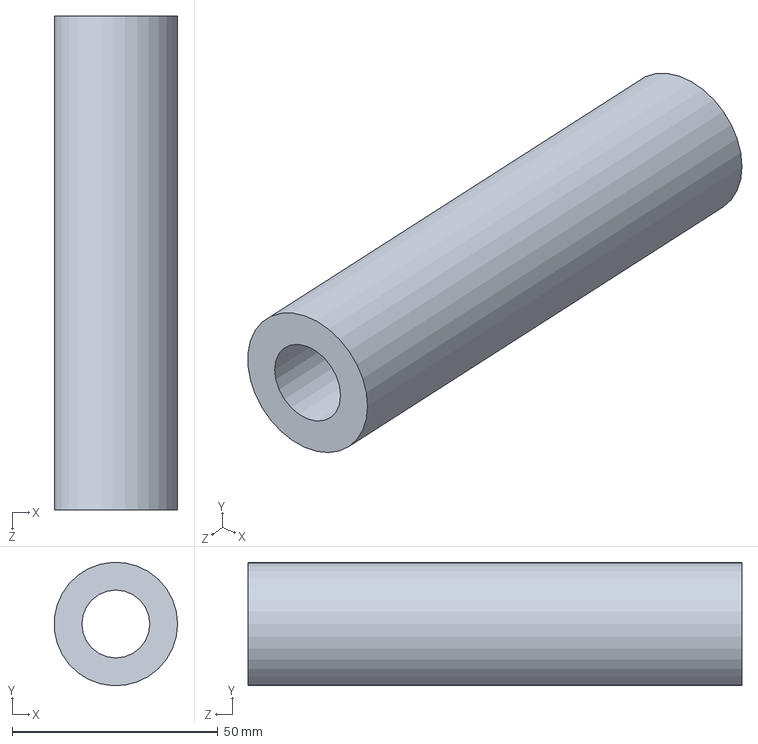
[picture p68: CAD file, 2019-07-03]
FORMA_WTRYSKOWA/CZĘŚĆI_ZNORMALIZOWANE/TPZ_30120_wg_FCPK.sldprt
29.9 x 30.0 x 120.0 mm
