ptymek/forma_wtryskowa_przts_WIP/FORMA_WTRYSKOWA/PK11_DOLNA.SLDPRT

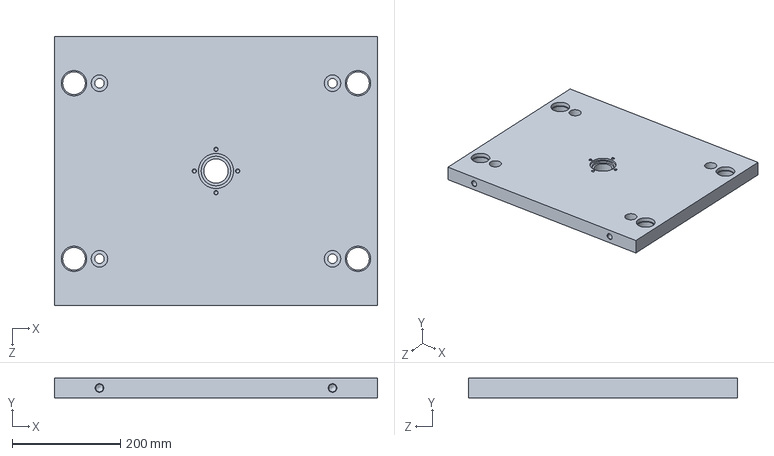
[picture p69: CAD file, 2019-07-03]
FORMA_WTRYSKOWA/PK11_DOLNA.SLDPRT
596.0 x 36.0 x 496.0 mm
