ptymek/forma_wtryskowa_przts_WIP/FORMA_WTRYSKOWA/CZĘŚĆI_ZNORMALIZOWANE/FCPKBYTOW/SLE_32046165_1_7131.sldprt

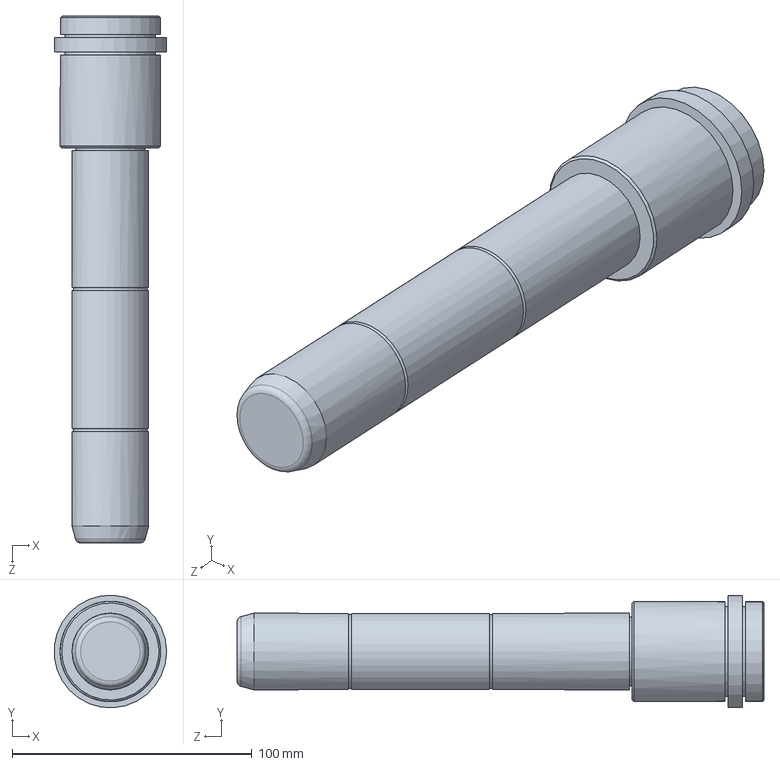
[picture p70: CAD file, 2019-07-03]
FORMA_WTRYSKOWA/CZĘŚĆI_ZNORMALIZOWANE/FCPKBYTOW/SLE_32046165_1_7131.sldprt
46.9 x 46.9 x 220.0 mm
