ptymek/forma_wtryskowa_przts_WIP/FORMA_WTRYSKOWA/WYPYCHACZ_PODKŁADKA.SLDPRT

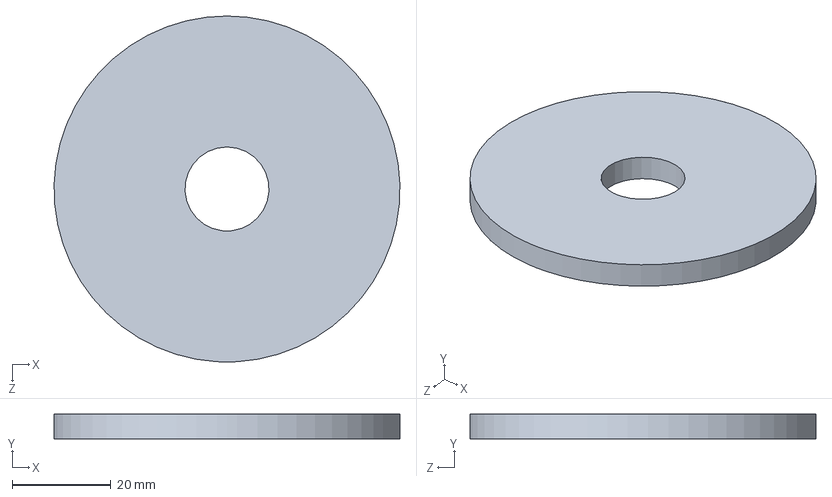
[picture p71: CAD file, 2019-07-03]
FORMA_WTRYSKOWA/WYPYCHACZ_PODKŁADKA.SLDPRT
70.0 x 5.00 x 70.0 mm
