ptymek/forma_wtryskowa_przts_WIP/FORMA_WTRYSKOWA/CZĘŚĆI_ZNORMALIZOWANE/PO_2803_wg_FCPK.sldprt

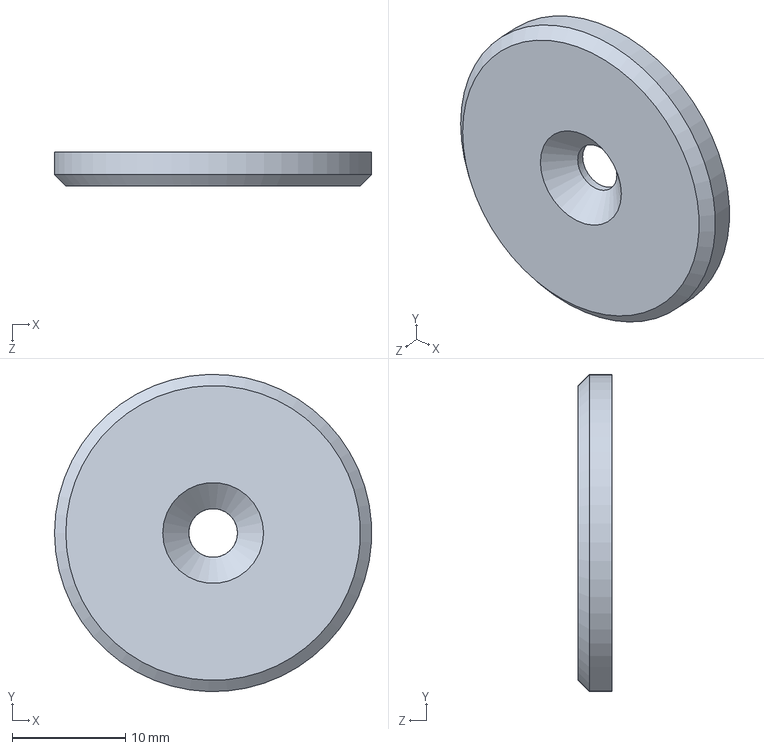
[picture p73: CAD file, 2019-07-03]
FORMA_WTRYSKOWA/CZĘŚĆI_ZNORMALIZOWANE/PO_2803_wg_FCPK.sldprt
28.0 x 28.0 x 3.00 mm
