ptymek/forma_wtryskowa_przts_WIP/FORMA_WTRYSKOWA/PK31_MATRYCA.SLDPRT

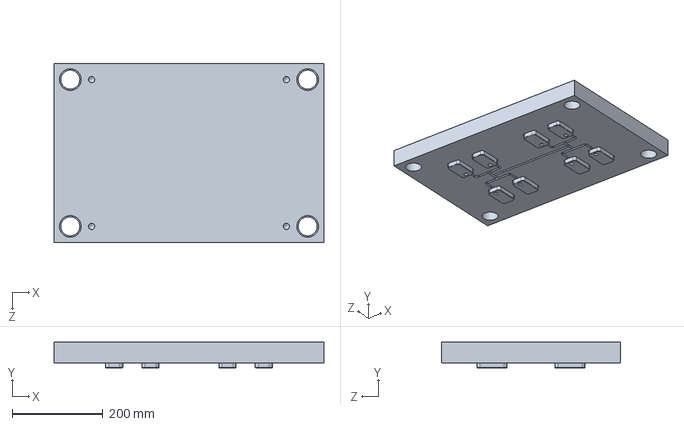
[picture p74: CAD file, 2019-07-03]
FORMA_WTRYSKOWA/PK31_MATRYCA.SLDPRT
596.0 x 57.2 x 396.0 mm
