ptymek/forma_wtryskowa_przts_WIP/FORMA_WTRYSKOWA/CZĘŚĆI_ZNORMALIZOWANE/FCPKBYTOW/PK06_268x596x22_35_1730_1_1730.sldprt

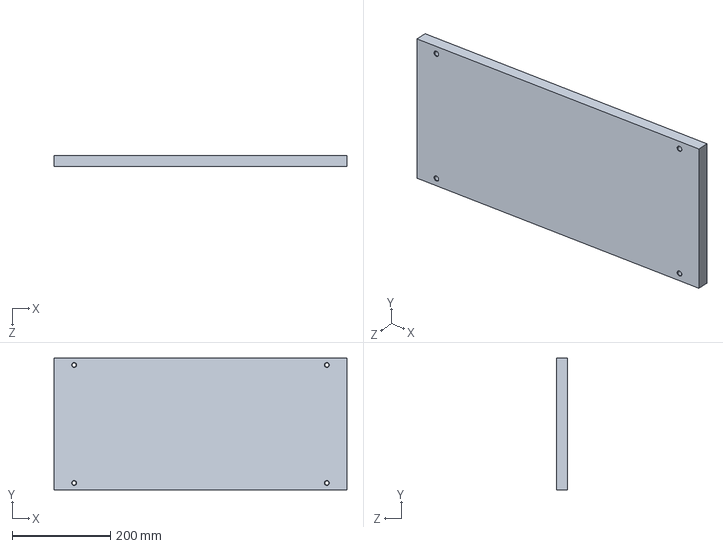
[picture p75: CAD file, 2019-07-03]
FORMA_WTRYSKOWA/CZĘŚĆI_ZNORMALIZOWANE/FCPKBYTOW/PK06_268x596x22_35_1730_1_1730.sldprt
596.0 x 268.0 x 22.0 mm
