ptymek/forma_wtryskowa_przts_WIP/FORMA_WTRYSKOWA/CZĘŚĆI_ZNORMALIZOWANE/KT_M8_MS58_Brass_.sldprt

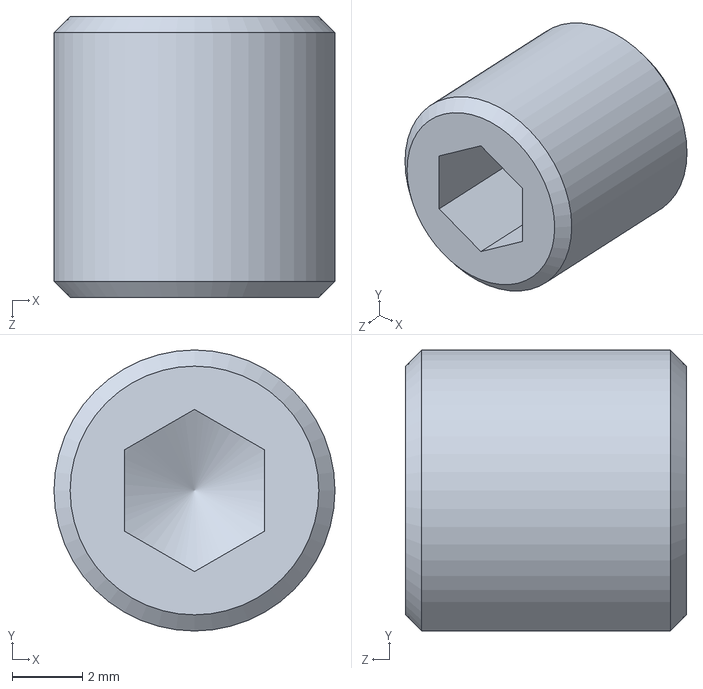
[picture p76: CAD file, 2019-07-03]
FORMA_WTRYSKOWA/CZĘŚĆI_ZNORMALIZOWANE/KT_M8_MS58_Brass_.sldprt
8.00 x 8.00 x 8.00 mm
