ptymek/forma_wtryskowa_przts_WIP/FORMA_WTRYSKOWA/PK06.SLDPRT

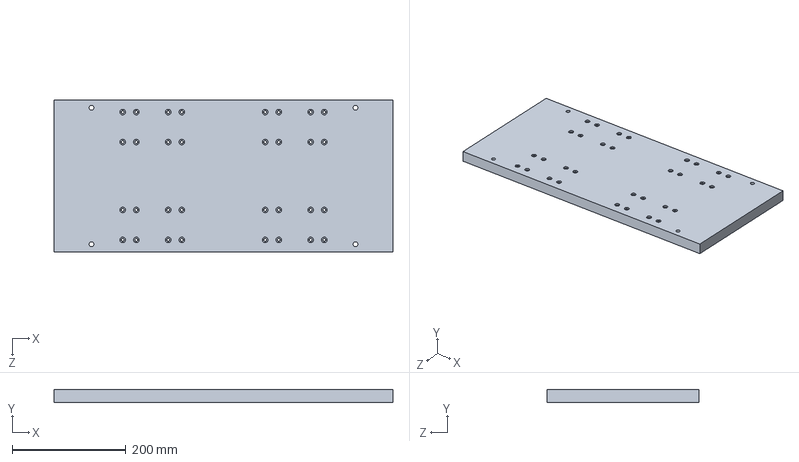
[picture p77: CAD file, 2019-07-03]
FORMA_WTRYSKOWA/PK06.SLDPRT
596.0 x 22.0 x 268.0 mm
