ptymek/forma_wtryskowa_przts_WIP/FORMA_WTRYSKOWA/CZĘŚĆI_ZNORMALIZOWANE/FCPKBYTOW/TPE_32046_1_7131.sldprt

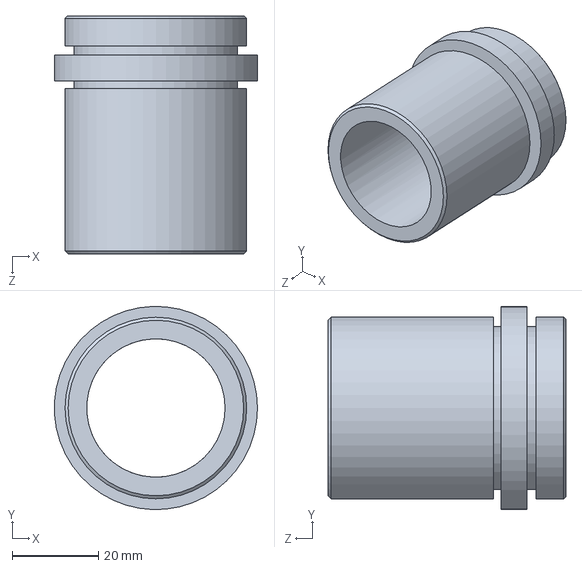
[picture p78: CAD file, 2019-07-03]
FORMA_WTRYSKOWA/CZĘŚĆI_ZNORMALIZOWANE/FCPKBYTOW/TPE_32046_1_7131.sldprt
46.9 x 47.0 x 55.0 mm
