ptymek/forma_wtryskowa_przts_WIP/FORMA_WTRYSKOWA/CZĘŚĆI_ZNORMALIZOWANE/TUE_42140_1_7131.sldprt

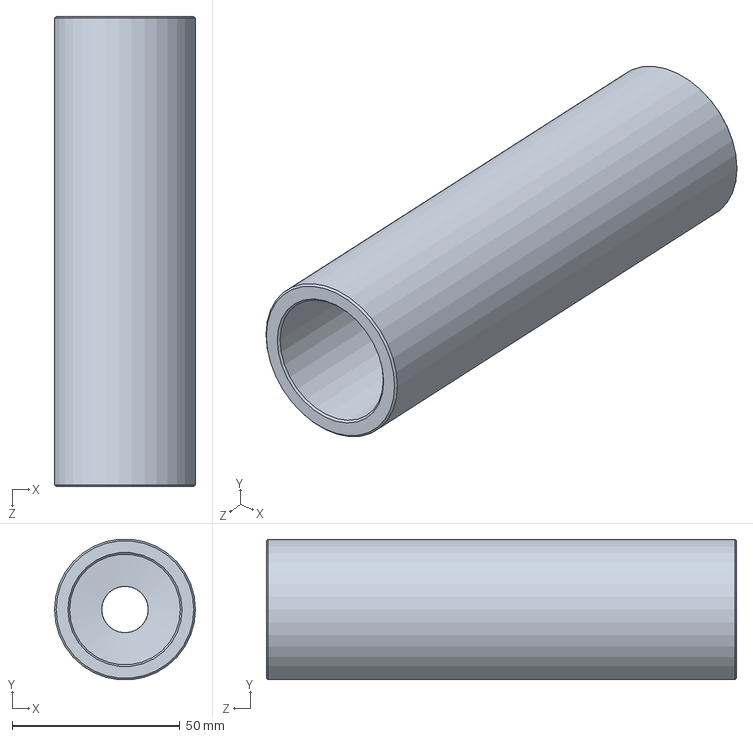
[picture p79: CAD file, 2019-07-03]
FORMA_WTRYSKOWA/CZĘŚĆI_ZNORMALIZOWANE/TUE_42140_1_7131.sldprt
42.0 x 41.8 x 140.0 mm
