ptymek/forma_wtryskowa_przts_WIP/FORMA_WTRYSKOWA/CZĘŚĆI_ZNORMALIZOWANE/FCPKBYTOW/SM_10035_wg_FCPK.sldprt

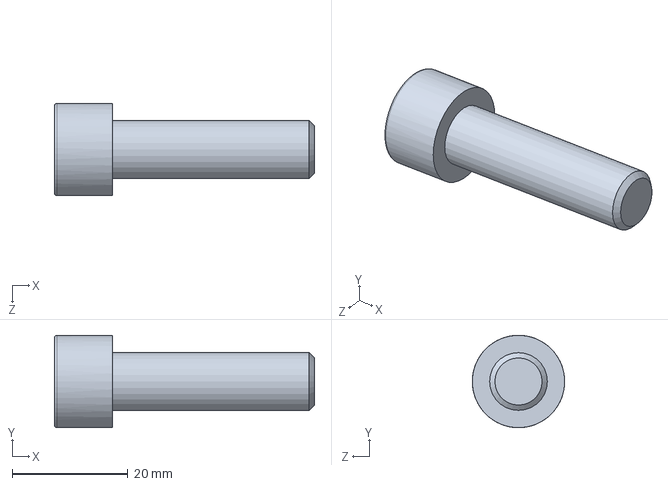
[picture p80: CAD file, 2019-07-03]
FORMA_WTRYSKOWA/CZĘŚĆI_ZNORMALIZOWANE/FCPKBYTOW/SM_10035_wg_FCPK.sldprt
45.0 x 16.0 x 16.0 mm
