ptymek/forma_wtryskowa_przts_WIP/FORMA_WTRYSKOWA/CZĘŚĆI_ZNORMALIZOWANE/TUE_42120_1_7131.sldprt

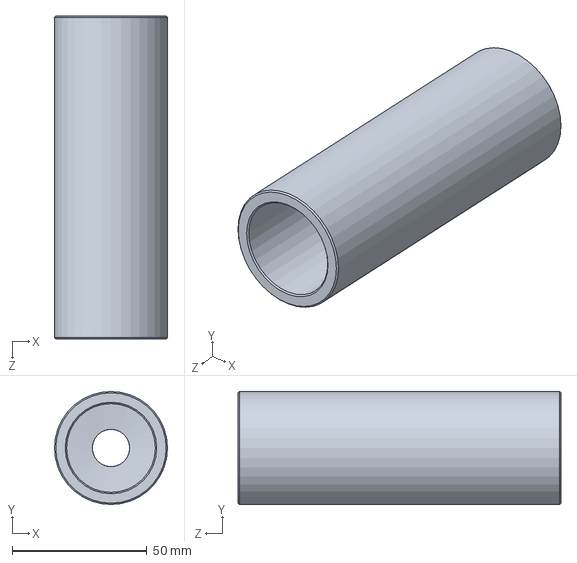
[picture p82: CAD file, 2019-07-03]
FORMA_WTRYSKOWA/CZĘŚĆI_ZNORMALIZOWANE/TUE_42120_1_7131.sldprt
42.0 x 42.0 x 120.0 mm
