ptymek/forma_wtryskowa_przts_WIP/FORMA_WTRYSKOWA/CZĘŚĆI_ZNORMALIZOWANE/PCA_125080_wg_FCPK.sldprt

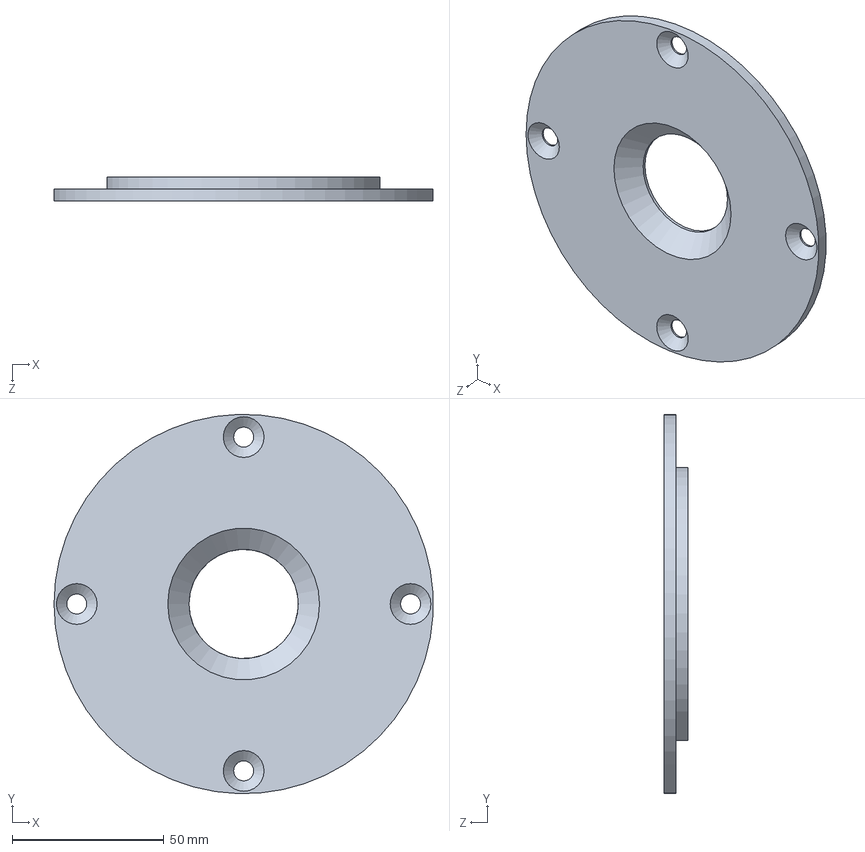
[picture p83: CAD file, 2019-07-03]
FORMA_WTRYSKOWA/CZĘŚĆI_ZNORMALIZOWANE/PCA_125080_wg_FCPK.sldprt
124.9 x 124.9 x 8.00 mm
