ptymek/forma_wtryskowa_przts_WIP/FORMA_WTRYSKOWA/CZĘŚĆI_ZNORMALIZOWANE/POA_5632_wg_FCPK.sldprt

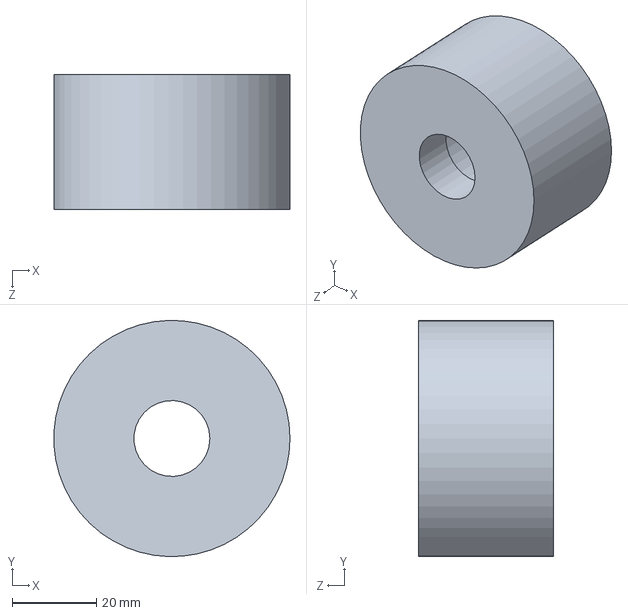
[picture p84: CAD file, 2019-07-03]
FORMA_WTRYSKOWA/CZĘŚĆI_ZNORMALIZOWANE/POA_5632_wg_FCPK.sldprt
55.9 x 56.0 x 32.0 mm
