ptymek/forma_wtryskowa_przts_WIP/FORMA_WTRYSKOWA/PK04.SLDPRT

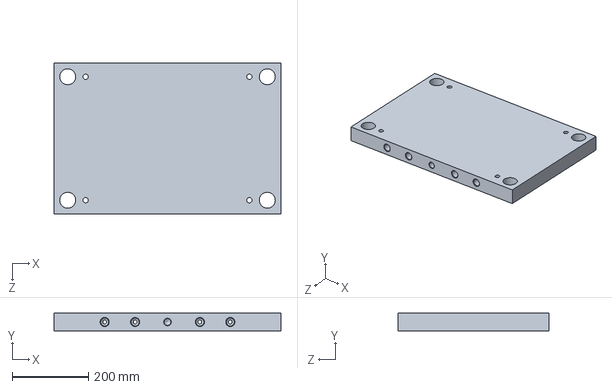
[picture p85: CAD file, 2019-07-03]
FORMA_WTRYSKOWA/PK04.SLDPRT
596.0 x 46.0 x 396.0 mm
