ptymek/forma_wtryskowa_przts_WIP/FORMA_WTRYSKOWA/CZĘŚĆI_ZNORMALIZOWANE/KT_M12_MS58_Brass_.sldprt

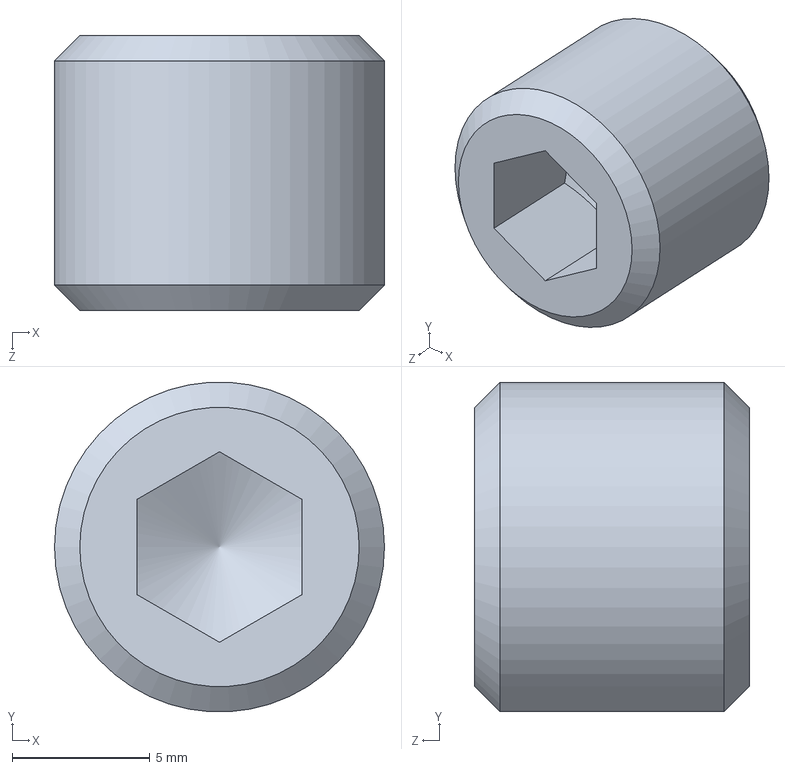
[picture p87: CAD file, 2019-07-03]
FORMA_WTRYSKOWA/CZĘŚĆI_ZNORMALIZOWANE/KT_M12_MS58_Brass_.sldprt
12.0 x 12.0 x 10.0 mm
