ptymek/forma_wtryskowa_przts_WIP/FORMA_WTRYSKOWA/CZĘŚĆI_ZNORMALIZOWANE/KT_M10_MS58_Brass_.sldprt

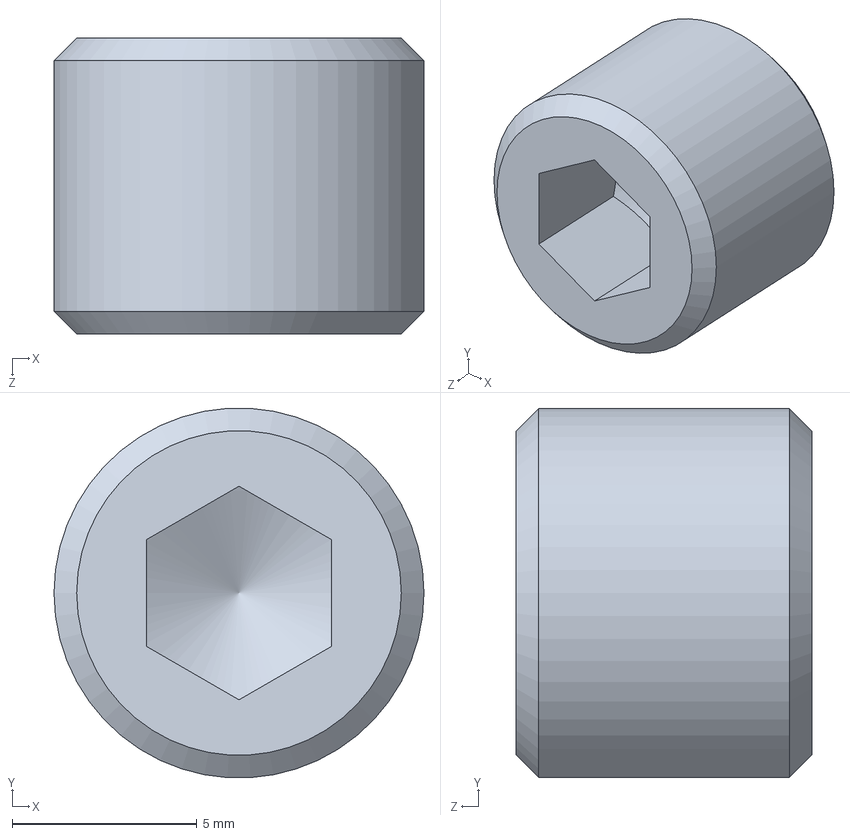
[picture p88: CAD file, 2019-07-03]
FORMA_WTRYSKOWA/CZĘŚĆI_ZNORMALIZOWANE/KT_M10_MS58_Brass_.sldprt
10.0 x 9.98 x 8.00 mm
