ptymek/forma_wtryskowa_przts_WIP/FORMA_WTRYSKOWA/CZĘŚĆI_ZNORMALIZOWANE/EM_050160_1_2344.sldprt

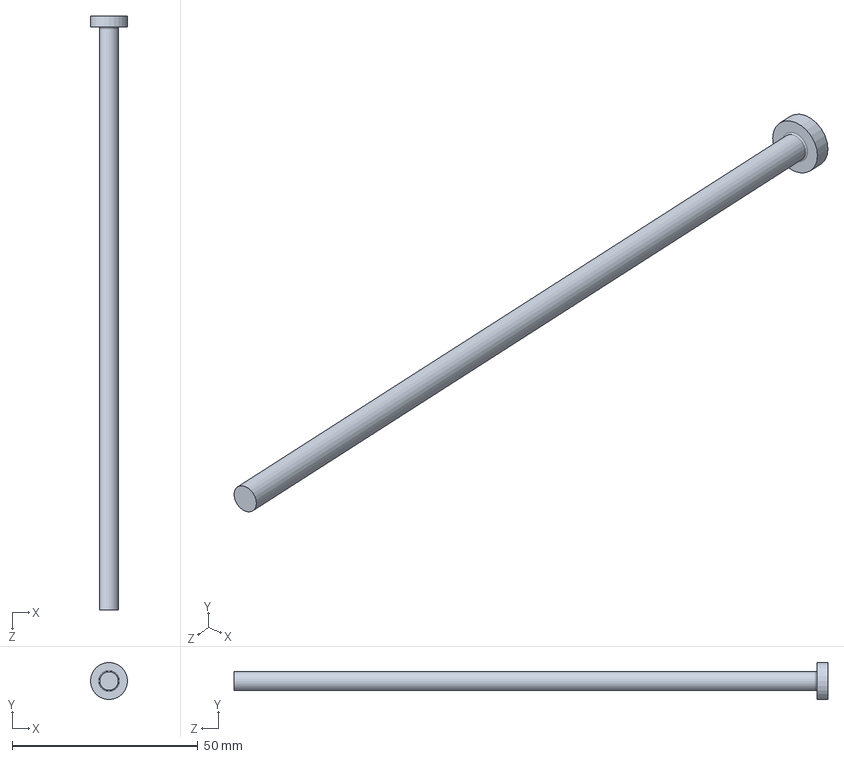
[picture p89: CAD file, 2019-07-03]
FORMA_WTRYSKOWA/CZĘŚĆI_ZNORMALIZOWANE/EM_050160_1_2344.sldprt
10.0 x 10.0 x 160.0 mm
