ptymek/forma_wtryskowa_przts_WIP/FORMA_WTRYSKOWA/CZĘŚĆI_ZNORMALIZOWANE/TWC_183056_1_8159.sldprt

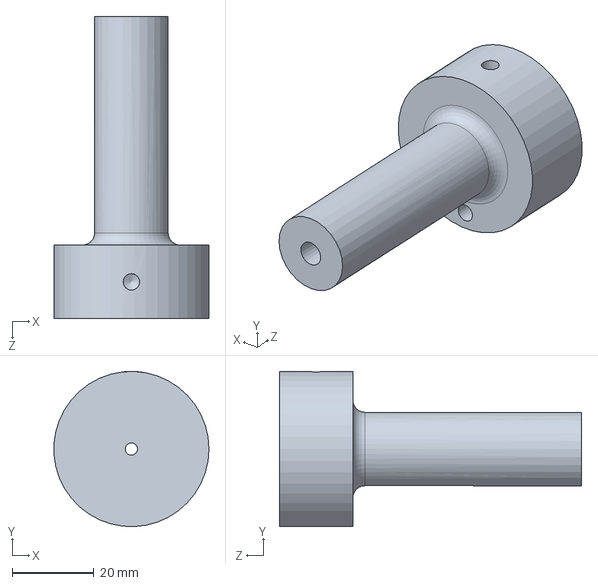
[picture p91: CAD file, 2019-07-03]
FORMA_WTRYSKOWA/CZĘŚĆI_ZNORMALIZOWANE/TWC_183056_1_8159.sldprt
37.9 x 38.0 x 74.0 mm
