ptymek/forma_wtryskowa_przts_WIP/(list of files, cad)

Other CAD files:
FORMA_WTRYSKOWA/CZĘŚĆI_ZNORMALIZOWANE/POA_1510_wg_FCPK.sldprt
FORMA_WTRYSKOWA/PK11_GÓRNA.SLDPRT
FORMA_WTRYSKOWA/CZĘŚĆI_ZNORMALIZOWANE/SLE_32046165_1_7131.sldprt
FORMA_WTRYSKOWA/SŁUP_PROWADZĄCY.SLDPRT
FORMA_WTRYSKOWA/CZĘŚĆI_ZNORMALIZOWANE/FCPKBYTOW/TUE_42140_1_7131.sldprt
FORMA_WTRYSKOWA/PK07.SLDPRT
FORMA_WTRYSKOWA/CZĘŚĆI_ZNORMALIZOWANE/FCPKBYTOW/PK01_496x596x36_35_1730_1_1730.sldprt
DRAW/PK31_FORMA.SLDDRW
DRAW/PK31_MATRYCA.SLDDRW
DRAW/TYMIŃSKI_PRZTS_WTRYSK.SLDDRW
DRAW/TYMIŃSKI_PRZTS_WYPRASKA.SLDDRW
FORMA_WTRYSKOWA/CZĘŚĆI_ZNORMALIZOWANE/FCPKBYTOW/PK_03_396x596x46_35_1730_1_1730.sldprt
FORMA_WTRYSKOWA/CZĘŚĆI_ZNORMALIZOWANE/socket head cap screw_iso.sldprt
WYPRASKA/TYMIŃSKI_PRZTS_WTRYSK.SLDPRT
