ptymek/forma_wtryskowa_przts_WIP/DRUK/PK31_FORMA_DRUK_A1.pdf

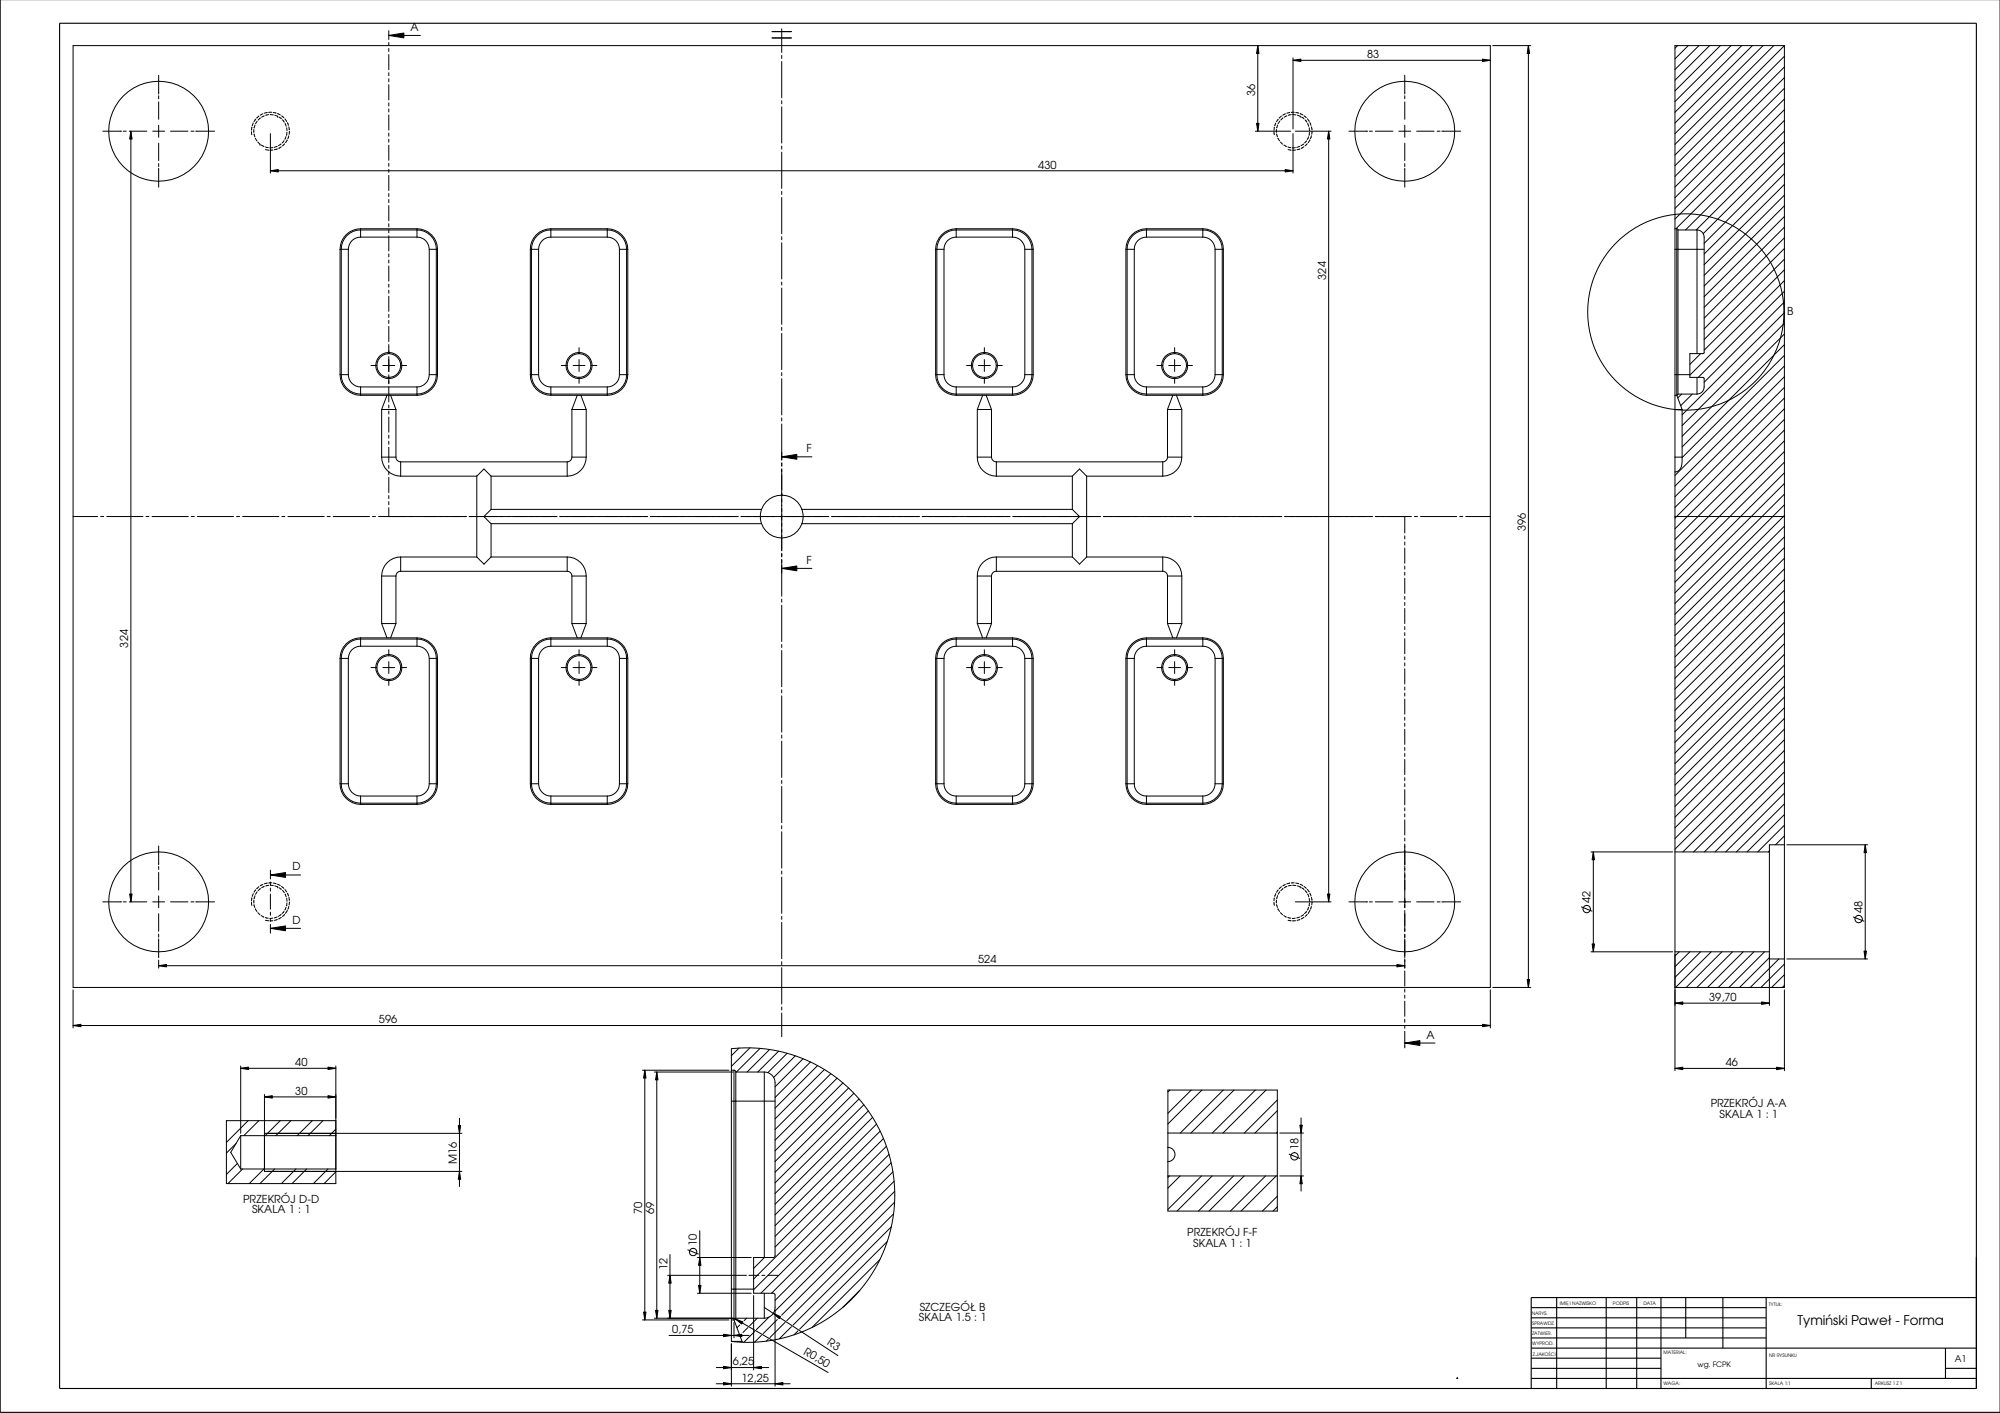
[picture p92: page 1]
PRZEKRÓJ A-A SKALA 1 : 1; WAGA:; SKALA 1:1; ARKUSZ 1 Z 1; SZCZEGÓŁ B SKALA 1.5 : 1; PRZEKRÓJ F-F SKALA 1 : 1; PRZEKRÓJ D-D SKALA 1 : 1

IMIĘ I NAZWISKO | PODPIS | DATA | | | | TYTUŁ: Tymiński Paweł - Forma

NARYS.
SPRAWDZ.
ZATWIER.
WYPROD.
Z.JAKOŚCI | | | | MATERIAL: wg. FCPK | NR RYSUNKU | A1
