ptymek/forma_wtryskowa_przts_WIP/DRUK/PK31_MATRYCA_DRUK_A1.pdf

83

596

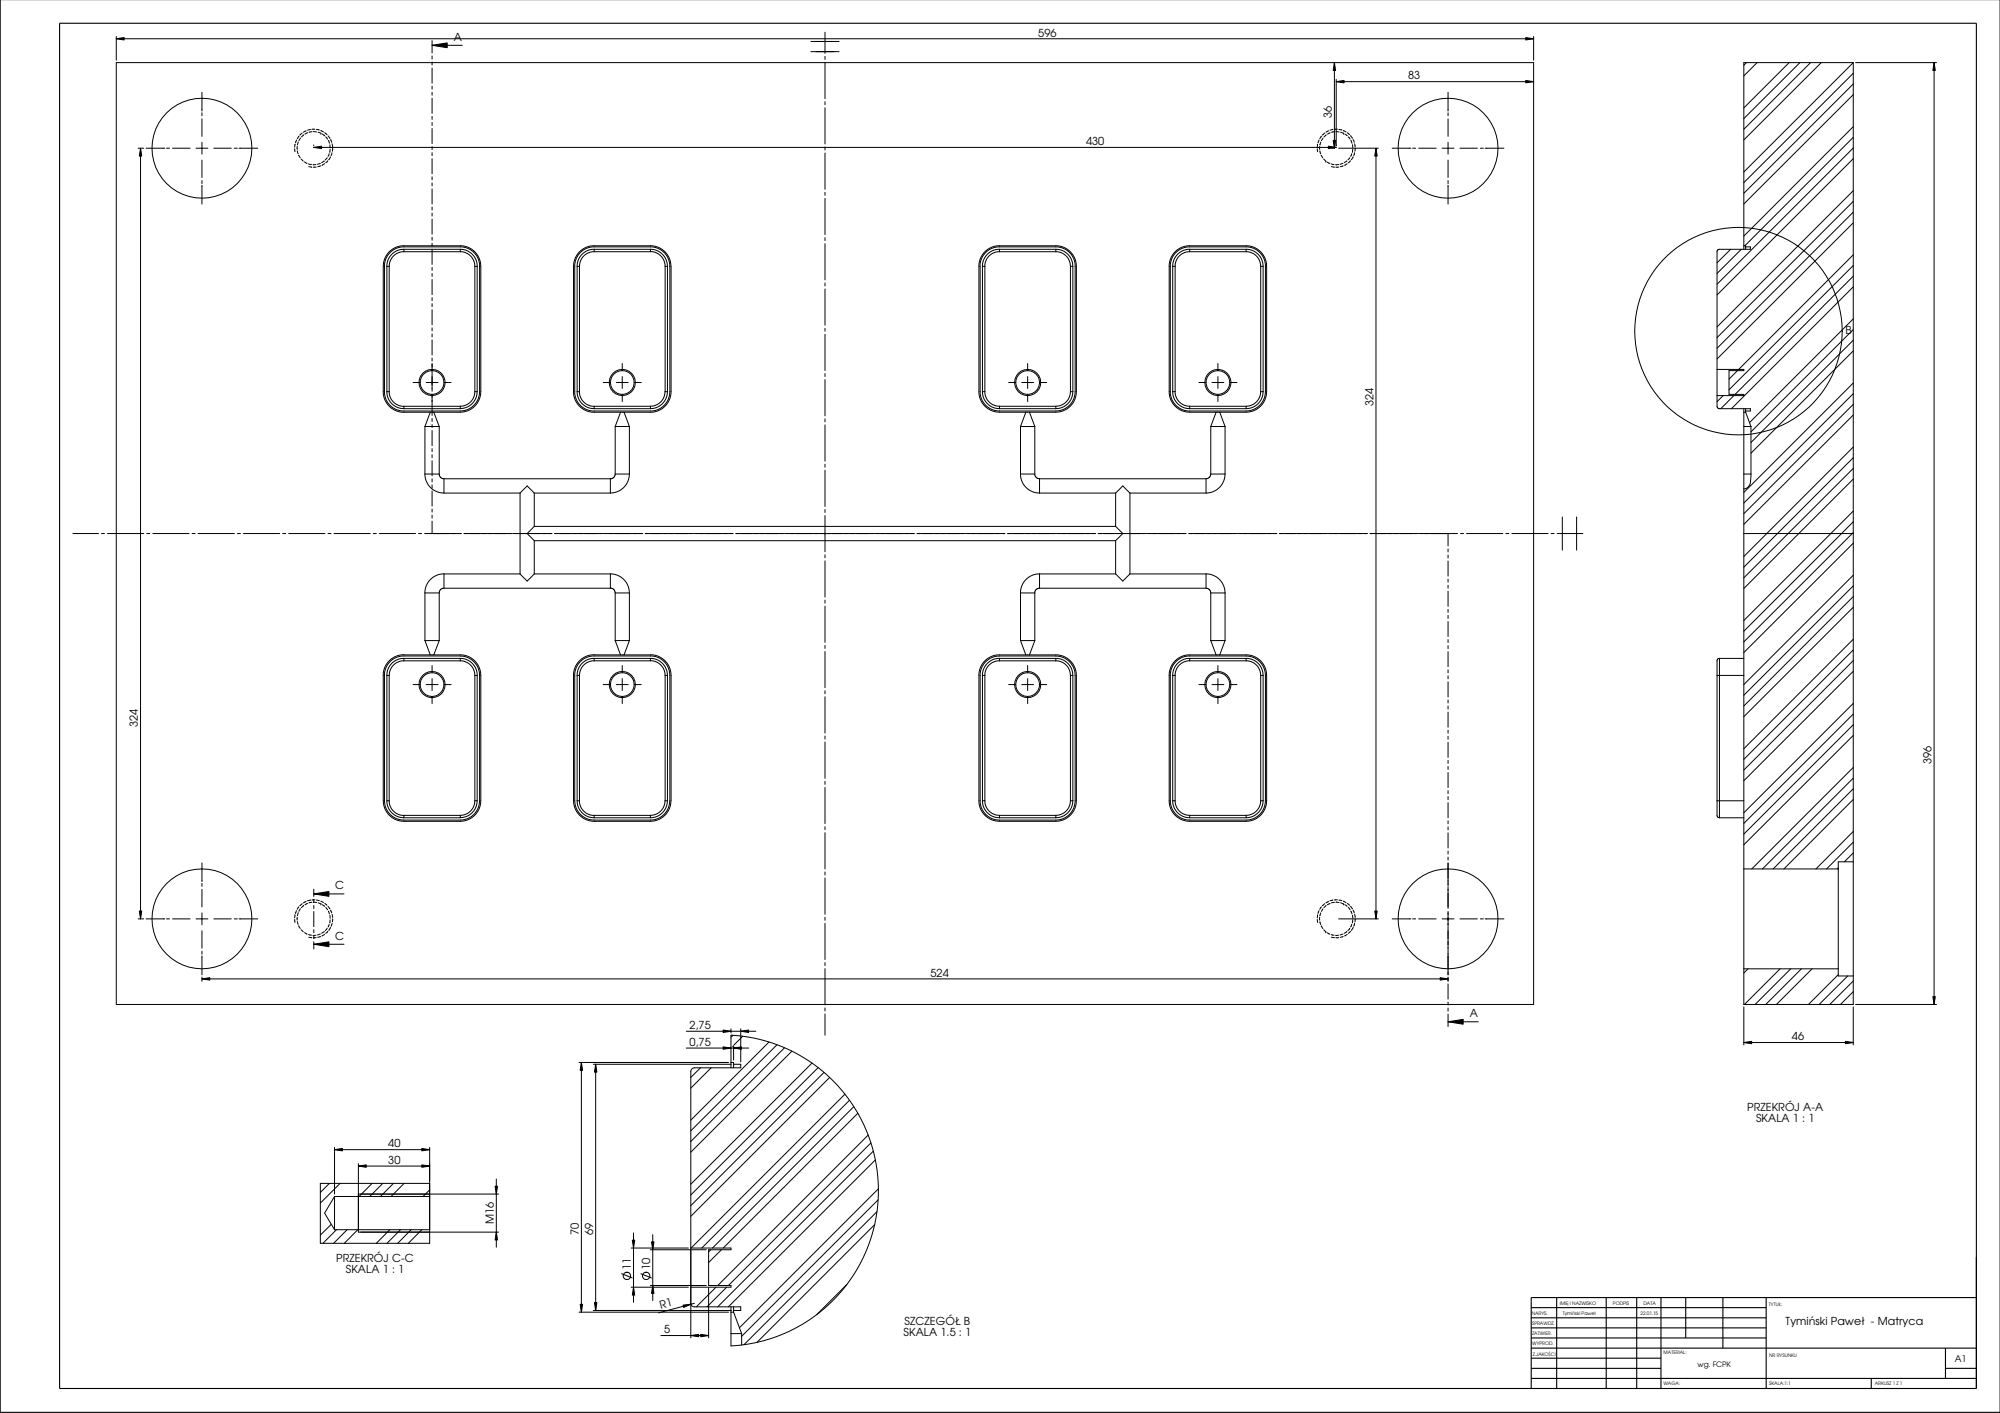
[picture p93: page 1]
WAGA:; SKALA:1:1; ARKUSZ 1 Z 1; SZCZEGÓŁ B; Tymiński Paweł - Matryca; SKALA 1.5 : 1; PRZEKRÓJ A-A SKALA 1 : 1; PRZEKRÓJ C-C SKALA 1 : 1

IMIĘ I NAZWISKO | PODPIS | DATA | | | | TYTUŁ:

NARYS. | Tymiński Paweł | | 22.01.15

SPRAWDZ.
ZATWIER.
WYPROD.
Z.JAKOŚCI | | | | MATERIAL: wg. FCPK | NR RYSUNKU | A1
