ptymek/forma_wtryskowa_przts_WIP/DRUK/TYMIŃSKI_FORMA_WTRYSKOWA_DRUK_A1.pdf

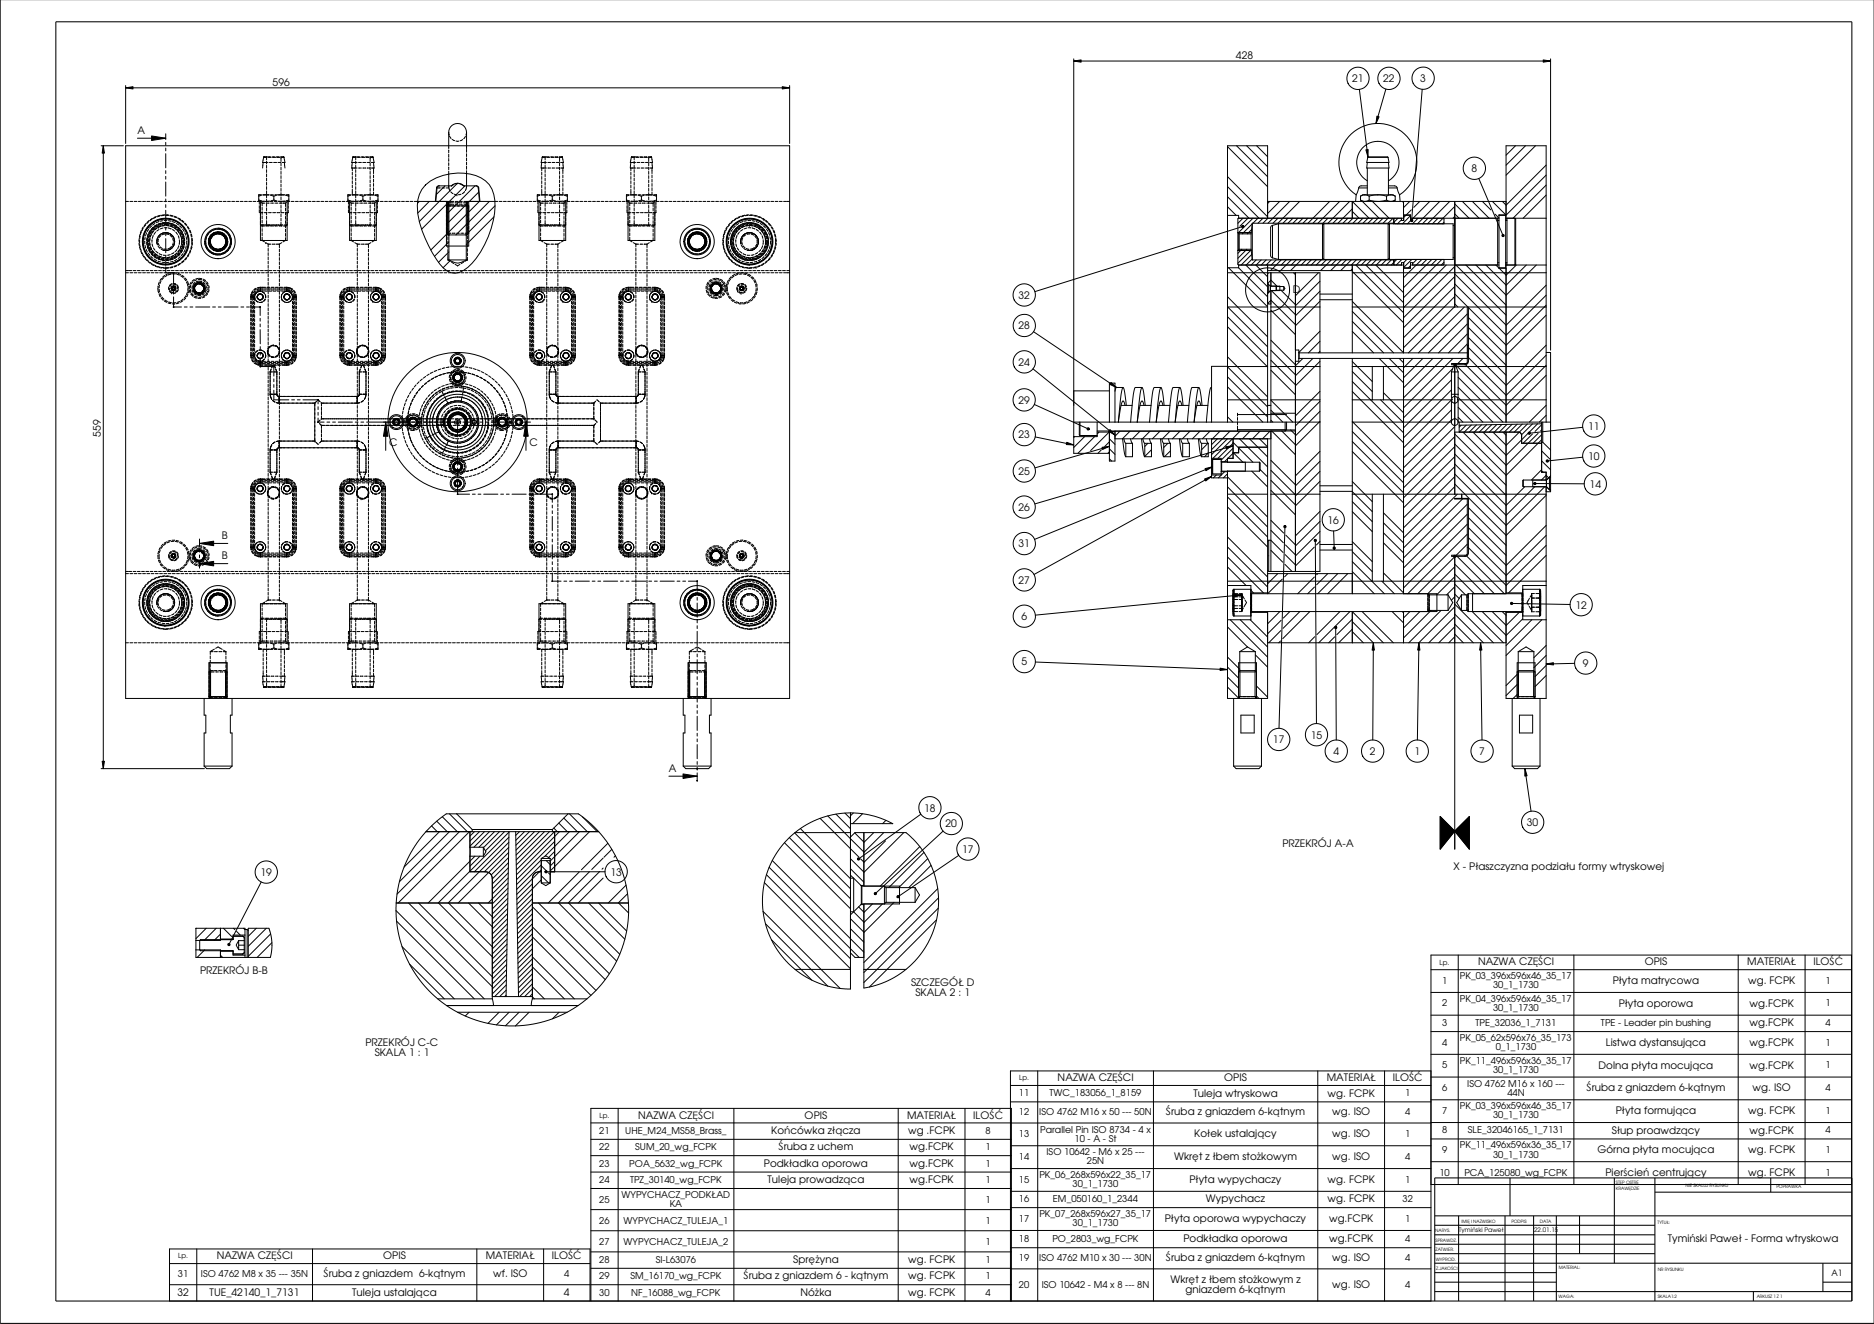
[picture p94: page 1]
WAGA:; SKALA1:2; ARKUSZ 1 Z 1; NIE SKALUJ RYSUNKU; POPRAWKA; KRAWĘDZIE; STĘP OSTRE; NAZWA CZĘŚCI; OPIS; MATERIAŁ; ILOŚĆ; Płyta matrycowa; wg. FCPK; Płyta oporowa; wg.FCPK; TPE_32036_1_7131; TPE - Leader pin bushing; Listwa dystansująca; Dolna płyta mocująca; ISO 4762 M16 x 160 --- 44N; Śruba z gniazdem 6-kątnym; wg. ISO; Płyta formująca; SLE_32046165_1_7131; Słup proawdzący; Górna płyta mocująca; PCA_125080_wg_FCPK; Pierścień centrujący; TWC_183056_1_8159; Tuleja wtryskowa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

X - Płaszczyzna podziału formy wtryskowej

IMIĘ I NAZWISKO | PODPIS | DATA | | | | TYTUŁ: Tymiński Paweł - Forma wtryskowa

NARYS. | Tymiński Paweł | | 22.01.15

SPRAWDZ.
ZATWIER.
WYPROD.
MATERIAL: Z.JAKOŚCI | NR RYSUNKU | A1
