ptymek/forma_wtryskowa_przts_WIP/DOC/TYMIŃSKI_PRZTS_WTRYSK_DRUK.pdf

A

39

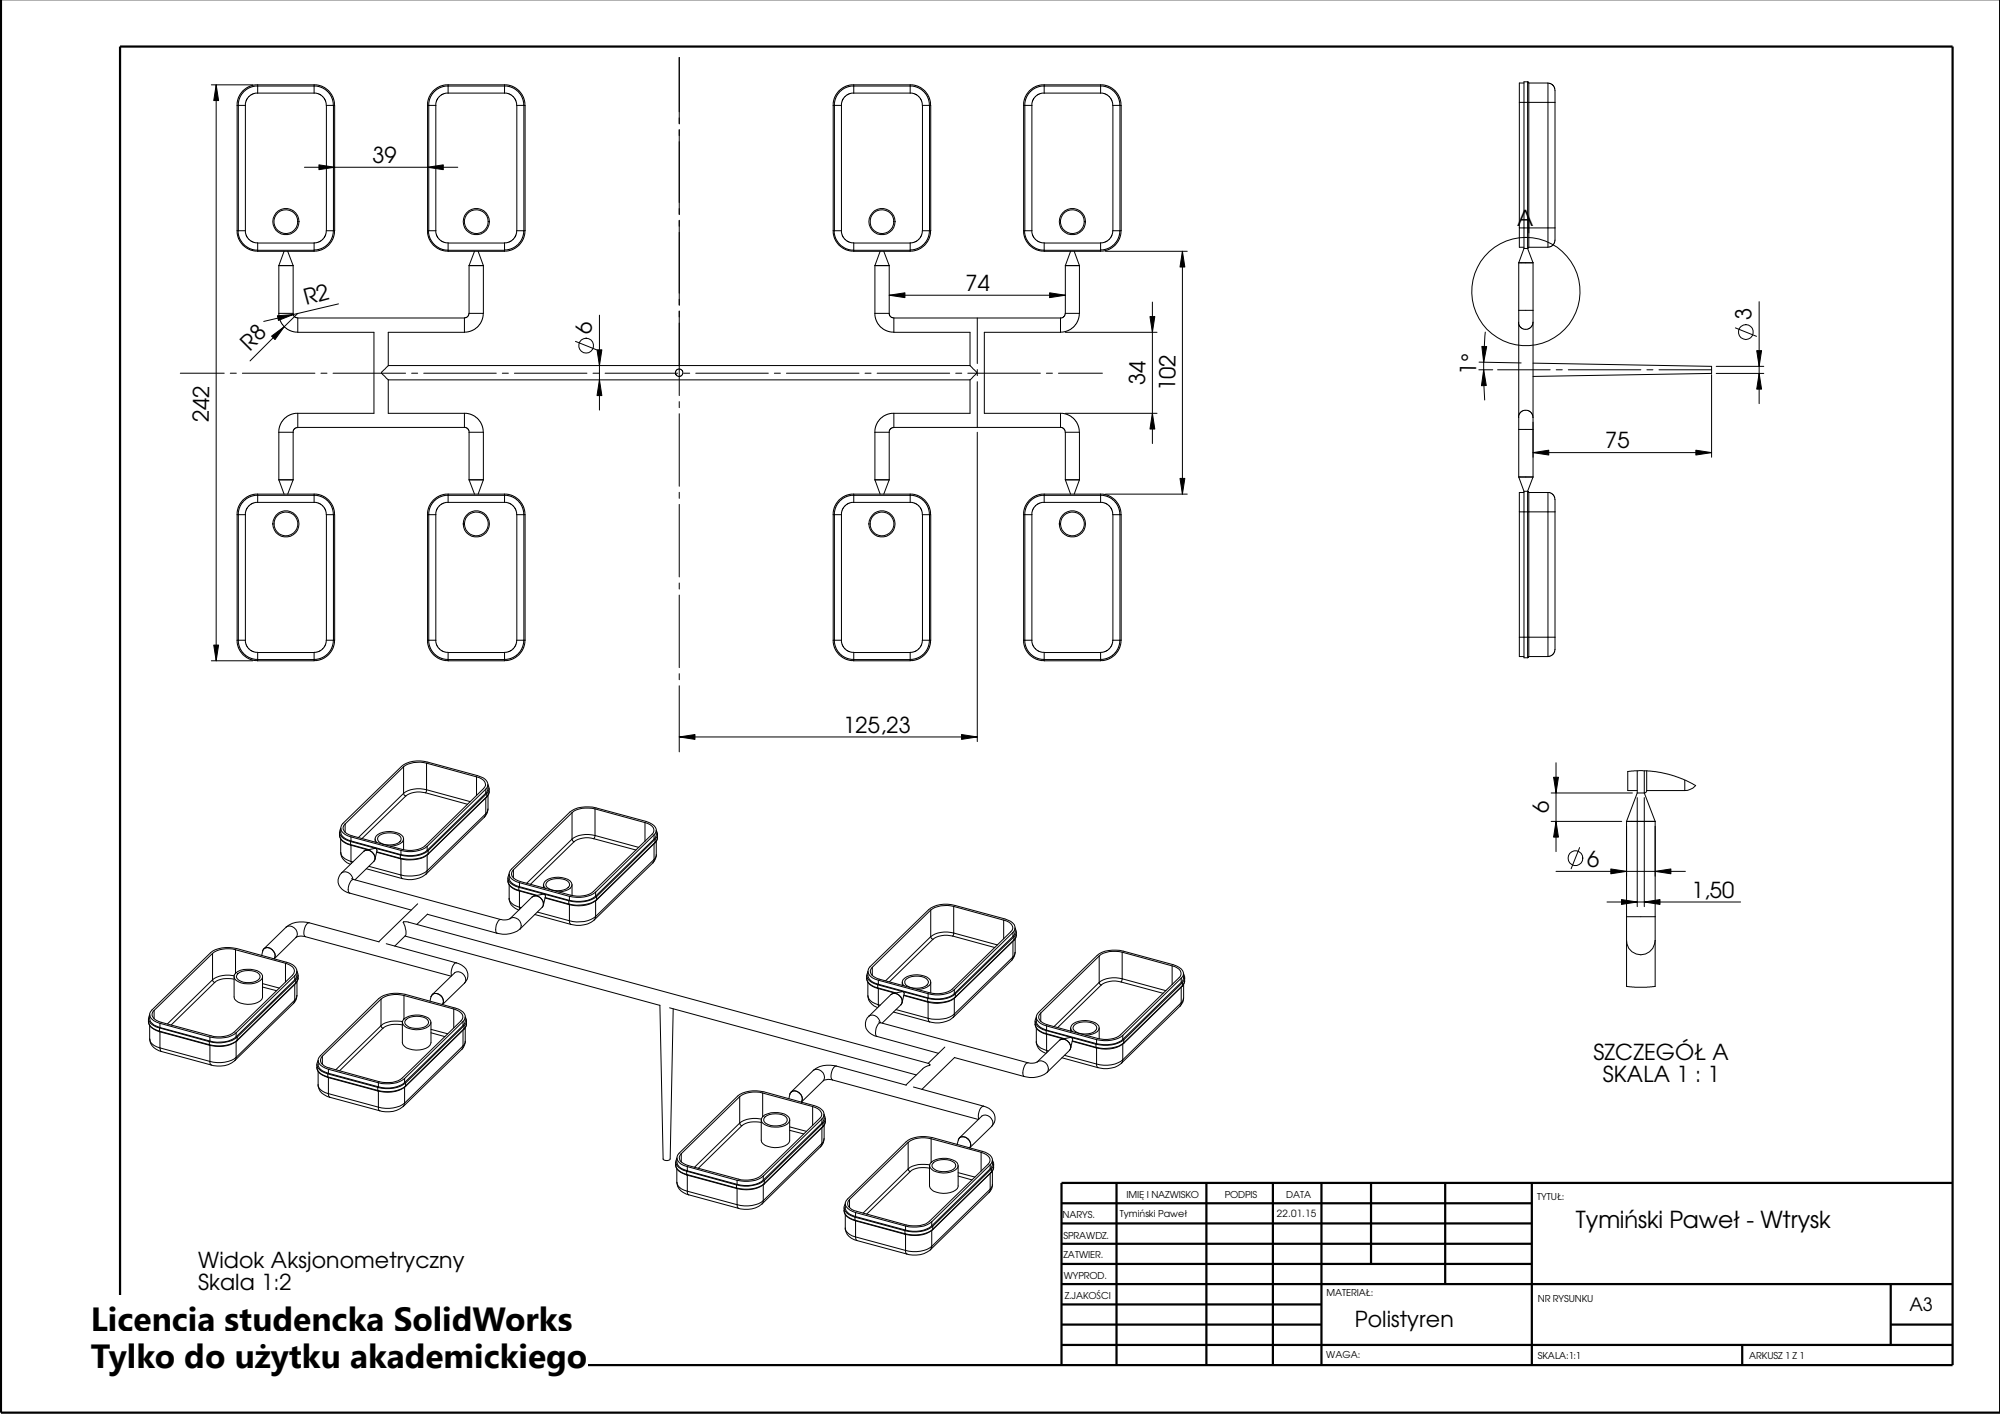
[picture p95: page 1]
WAGA:; SKALA:1:1; ARKUSZ 1 Z 1; SZCZEGÓŁ A SKALA 1 : 1; Skala 1:2; Widok Aksjonometryczny

IMIĘ I NAZWISKO | PODPIS | DATA | TYTUŁ: Tymiński Paweł - Wtrysk
SPRAWDZ. NARYS. | Tymiński Paweł | | 22.01.15

ZATWIER.
Z.JAKOŚCI | MATERIAŁ: Polistyren | NR RYSUNKU | A3

WYPROD.

Licencja studencka SolidWorks
Tylko do użytku akademickiego
