ptymek/forma_wtryskowa_przts_WIP/DRAW/TYMIŃSKI_PRZTS_WYPRASKA - Arkusz2.pdf

A

# SZCZEGÓŁ A

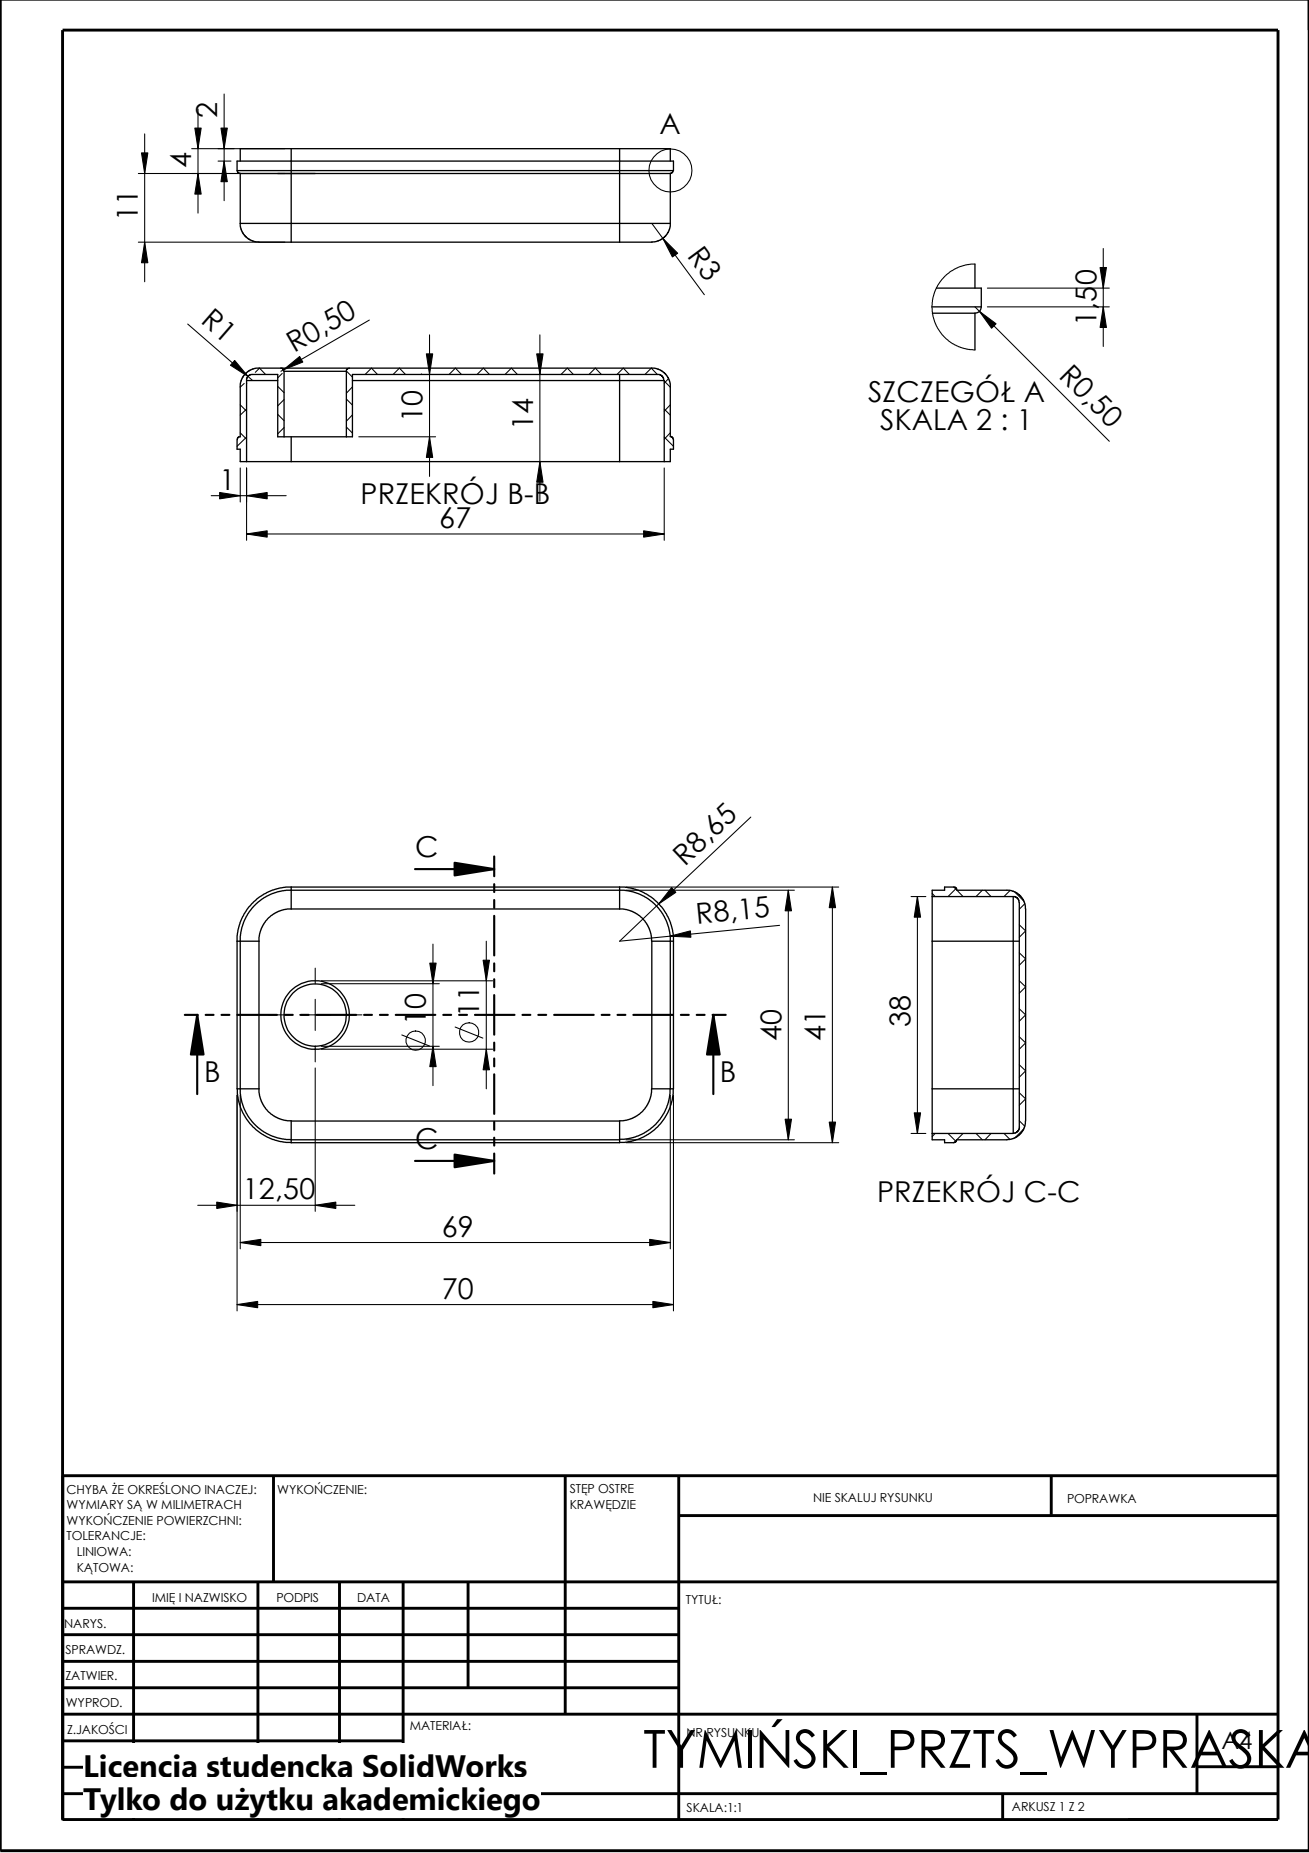
[picture p96: page 1]
PRZEKRÓJ C-C ³⁸; SKALA 2 : 1; PRZEKRÓJ B-B 67; TYMIŃSKI_PRZTS_WYPRASKA; NIE SKALUJ RYSUNKU; POPRAWKA; STĘP OSTRE; WYKOŃCZENIE:; KRAWĘDZIE

CHYBA ŻE OKREŚLONO INACZEJ:
WYMIARY SĄ W MILIMETRACH
WYKOŃCZENIE POWIERZCHNI:
TOLERANCJE:
LINIOWA:
KĄTOWA:

IMIĘ I NAZWISKO | PODPIS | DATA | | | | TYTUŁ:

NARYS.

SPRAWDZ.

ZATWIER.

WYPROD.
Z.JAKOŚCI | | | | MATERIAŁ: | NR RYSUNKU | A4
Licencja studencka SolidWorks

Tylko do użytku akademickiego | | | | WAGA: | SKALA:1:1 | ARKUSZ 1 Z 2

D D

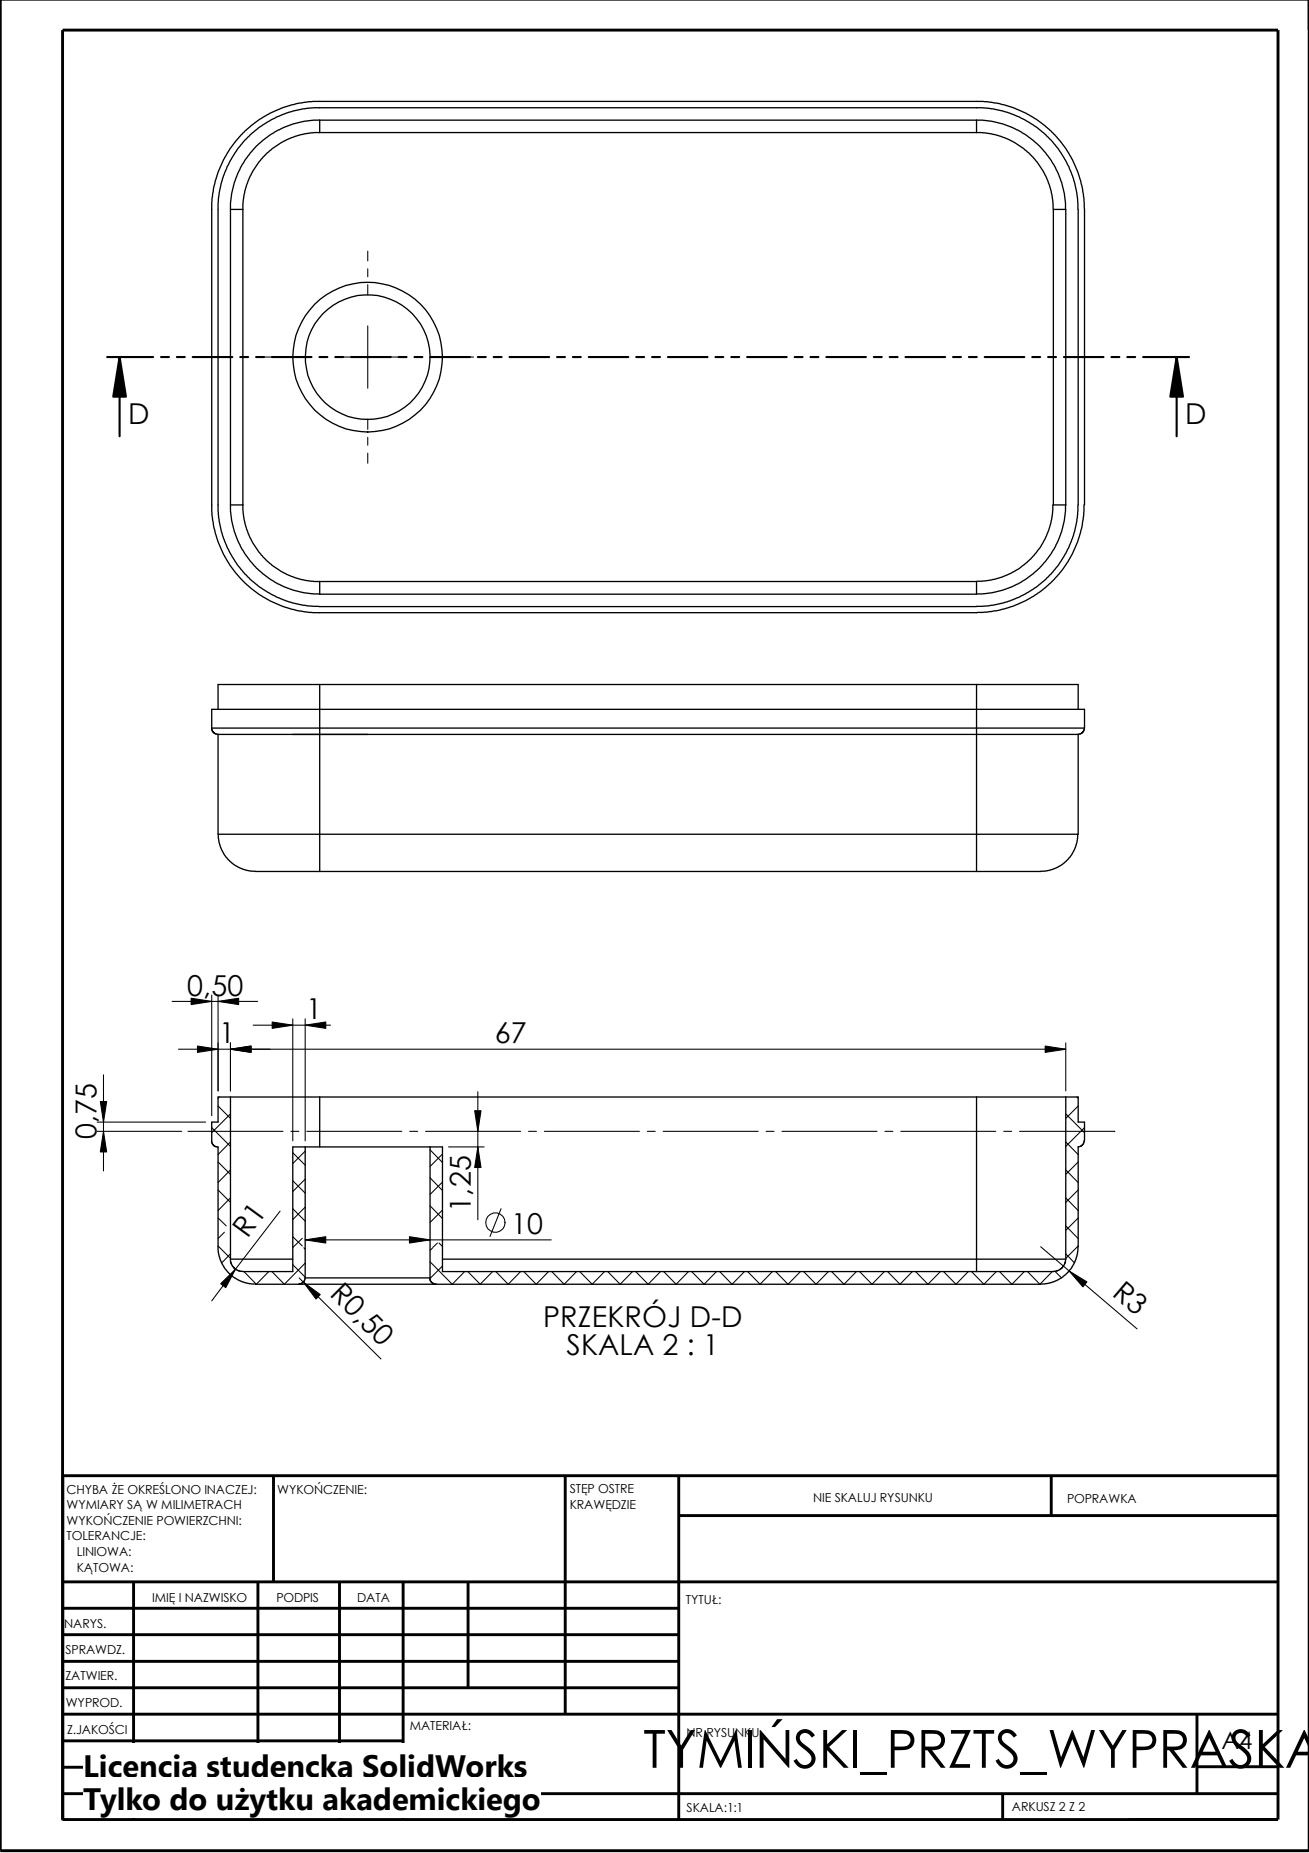
[picture p97: page 2]
PRZEKRÓJ D-D SKALA 2 : 1; TYMIŃSKI_PRZTS_WYPRASKA; NIE SKALUJ RYSUNKU; POPRAWKA; WYKOŃCZENIE:; KRAWĘDZIE; CHYBA ŻE OKREŚLONO INACZEJ:; STĘP OSTRE

WYMIARY SĄ W MILIMETRACH
WYKOŃCZENIE POWIERZCHNI:
TOLERANCJE:
LINIOWA:
KĄTOWA:

IMIĘ I NAZWISKO | PODPIS | DATA | | | | TYTUŁ:

NARYS.

SPRAWDZ.

ZATWIER.

WYPROD.
Licencja studencka SolidWorks

Z.JAKOŚCI | | | | MATERIAŁ: | NR RYSUNKU | A4

Tylko do użytku akademickiego | | | | WAGA: | SKALA:1:1 | ARKUSZ 2 Z 2
