ptymek/forma_wtryskowa_przts_WIP/DRAW/TYMIŃSKI_PRZTS_WYPRASKA.pdf

# SZCZEGÓŁ A SKALA 2 : 1

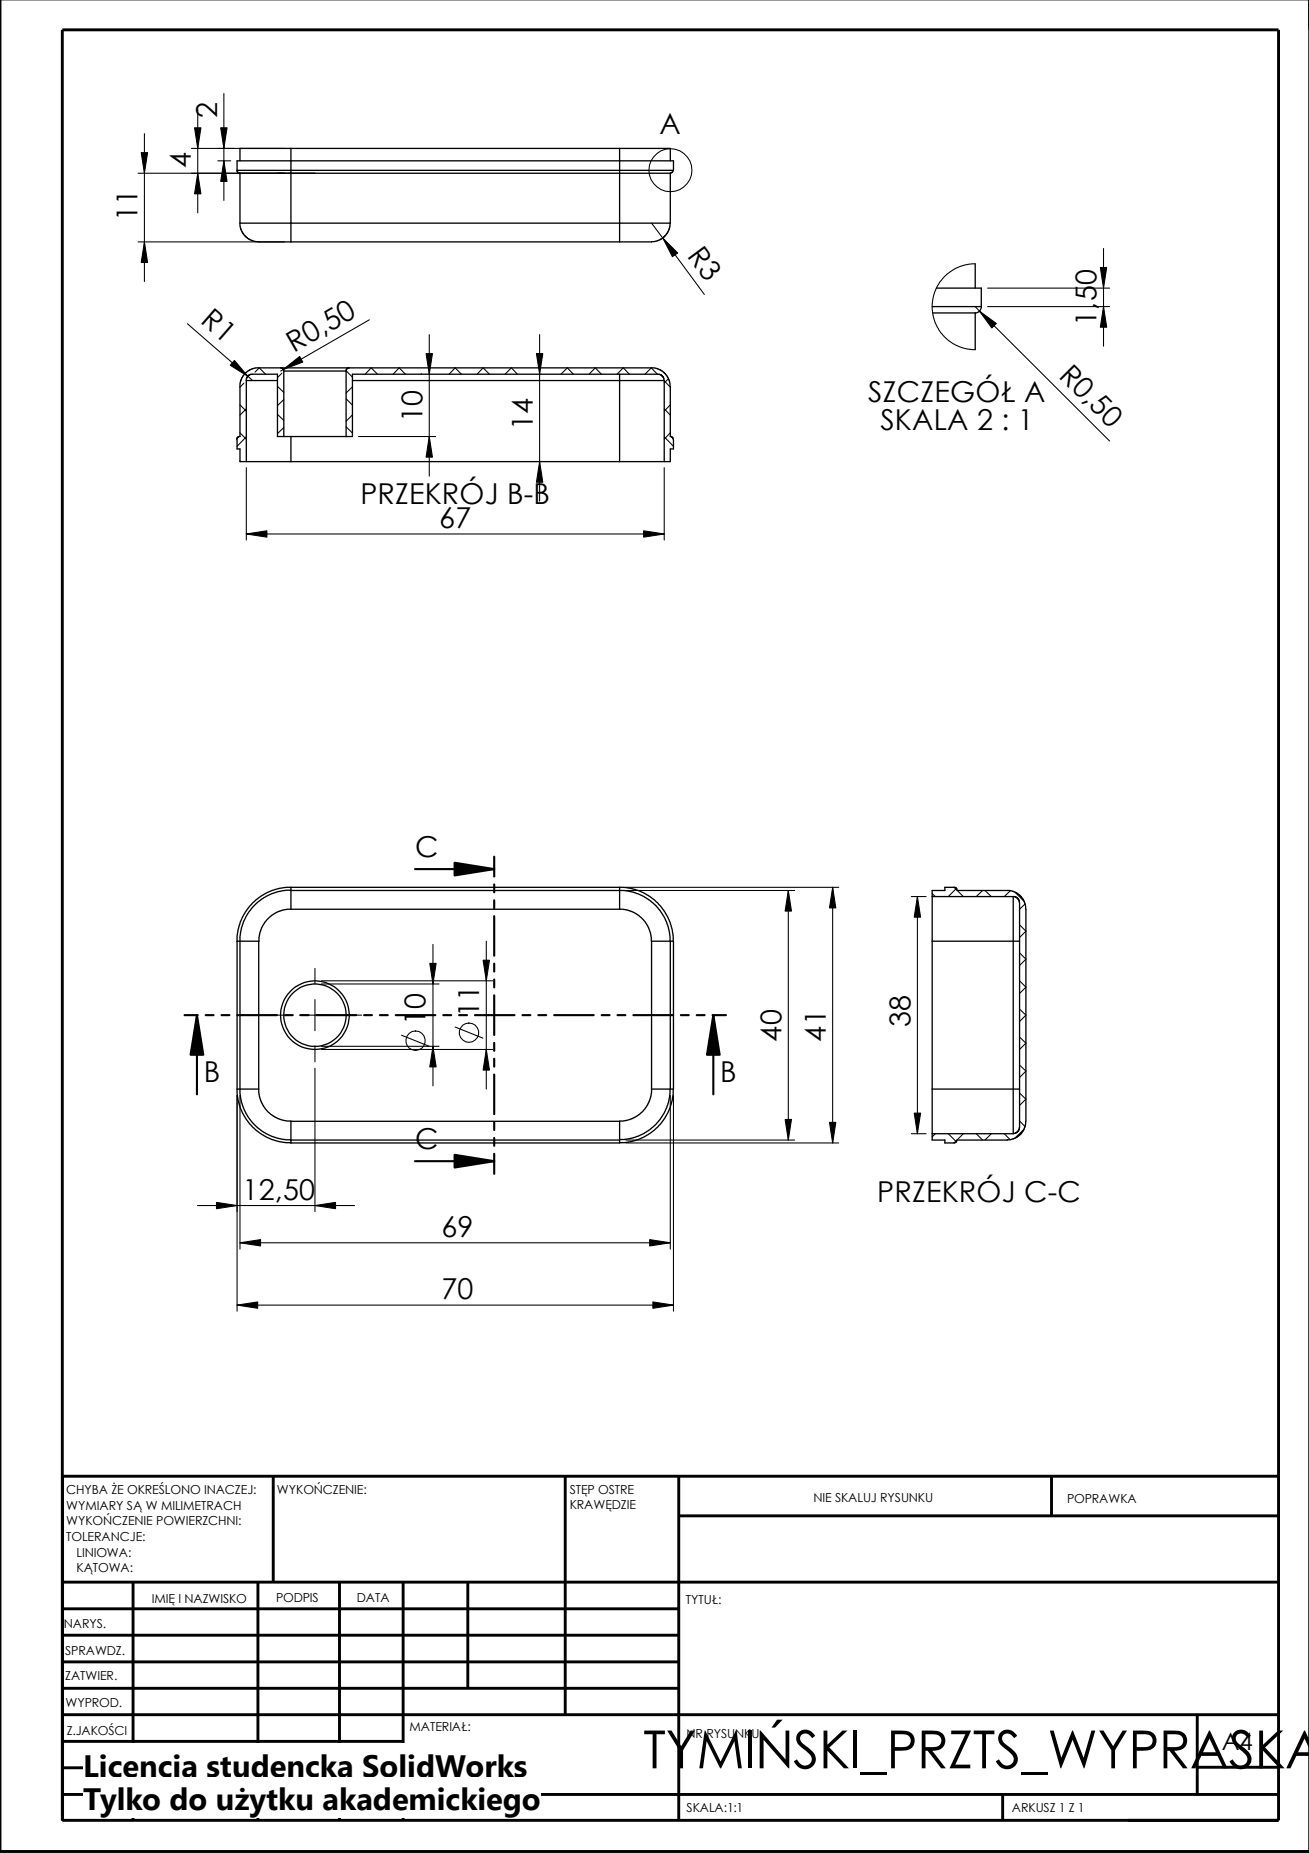
[picture p98: page 1]
TYMIŃSKI_PRZTS_WYPRASKA; NIE SKALUJ RYSUNKU; POPRAWKA; STĘP OSTRE; WYKOŃCZENIE:; KRAWĘDZIE; PRZEKRÓJ B-B 67; PRZEKRÓJ C-C ³⁸

CHYBA ŻE OKREŚLONO INACZEJ:
WYMIARY SĄ W MILIMETRACH
WYKOŃCZENIE POWIERZCHNI:
TOLERANCJE:
LINIOWA:
KĄTOWA:

IMIĘ I NAZWISKO | PODPIS | DATA | | | | TYTUŁ:

NARYS.

SPRAWDZ.

ZATWIER.

WYPROD.
Z.JAKOŚCI | | | | MATERIAŁ: | NR RYSUNKU | A4
Licencja studencka SolidWorks

Tylko do użytku akademickiego | | | | WAGA: | SKALA:1:1 | ARKUSZ 1 Z 1
