ptymek/forma_wtryskowa_przts_WIP/DRUK/TYMIŃSKI_PRZTS_WYPRASKA_DRUK_A4.pdf

11
A

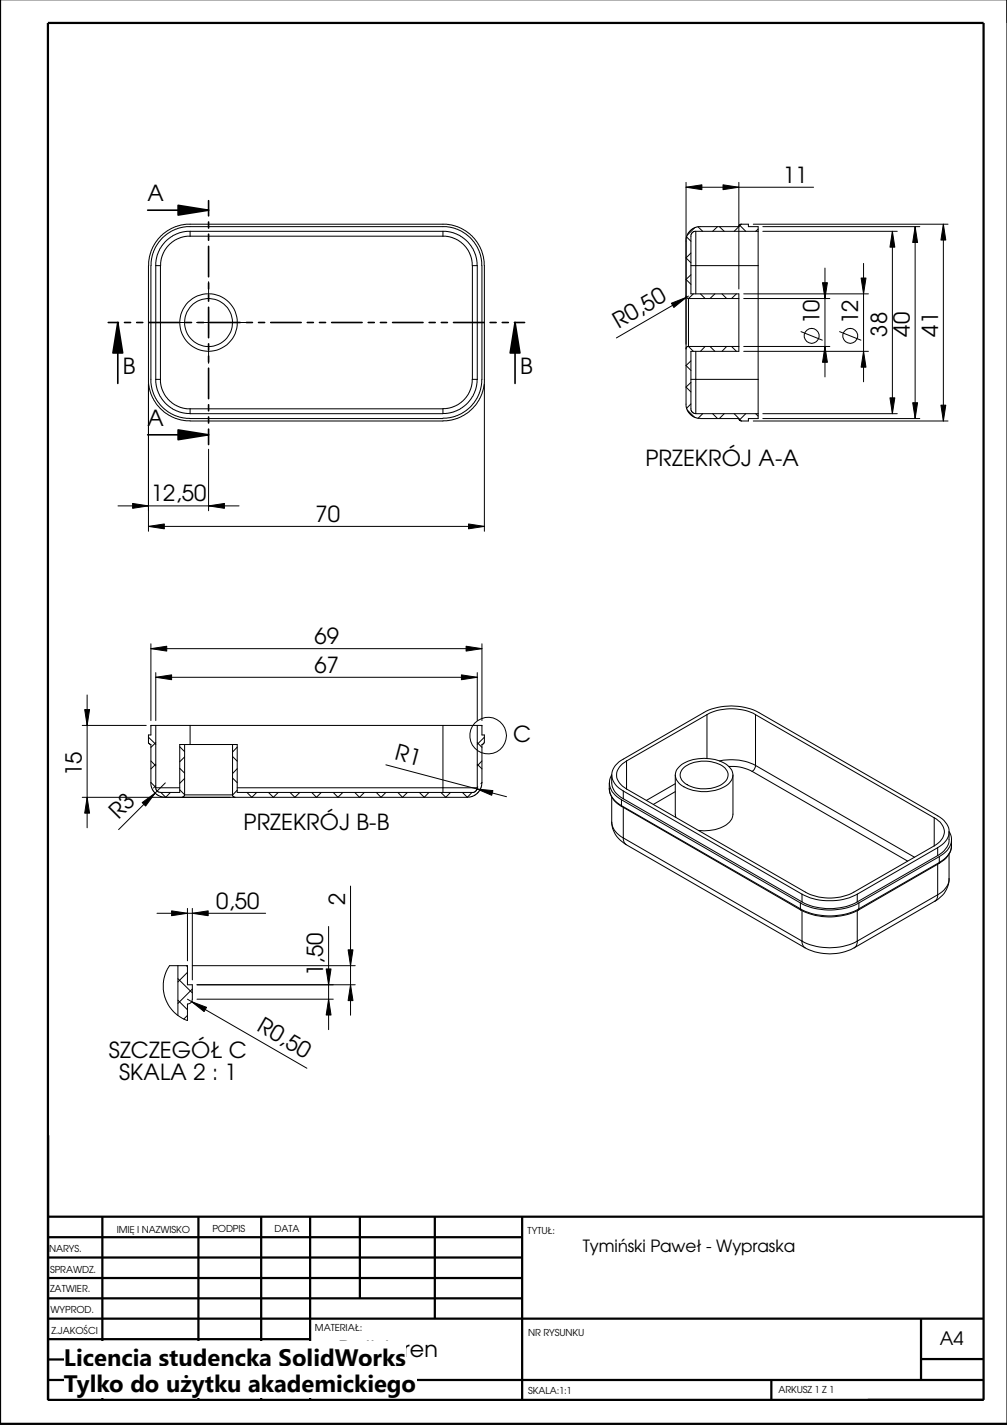
[picture p99: page 1]
PRZEKRÓJ B-B; SZCZEGÓŁ C SKALA 2 : 1; PRZEKRÓJ A-A

IMIĘ I NAZWISKO | PODPIS | DATA | | | | TYTUŁ: Tymiński Paweł - Wypraska
NARYS.

SPRAWDZ.
ZATWIER.
WYPROD.
Z.JAKOŚCI | | | | MATERIAŁ: Polistyren | NR RYSUNKU | A4
Licencja studencka SolidWorks

Tylko do użytku akademickiego | | | | WAGA: | SKALA:1:1 | ARKUSZ 1 Z 1
